momszx/esp32-p4-cam/docs/hu/01-esp32-p4.md

> ⚠️ Kutatási jegyzet (2026-10-09). Ahol ellentmond a 05-architektura.md-nek, a 05 érvényes. Ismert elavult pontok: a „54-es láb” a chip VDD_HP_1 lába, nem GPIO54 (F-1; GPIO54 = C6_EN, E18); a 01 lábszámai chip QFN-lábak, a 05 modul-padszámokat használ (E-7); bare QFN104 helyett Waveshare modul (D1, E-36) – a NYÁK **nem** 2 rétegű: a „max 2 réteg” korlát megszűnt, a MAIN v0.6 **4 rétegű, 45×45 mm** (00 K4, 05 §3.2), így a 8. fejezet 2 rétegű megszorításai a MAIN-re nem érvényesek; VDDPST_5 külső 3,3 V helyett on-chip VO4 LDO (E-3, E-5); az USB HS nem használt, egyetlen USB-C a GPIO24/25 USB-Serial-JTAG (F-9).

# 01 – ESP32-P4 hardver-kutatás (kamera panel projekt)

Dátum: 2026-10-09

## 0. FONTOS: a kutatás korlátai

- A **WebFetch eszköz ebben a futásban végig blokkolva volt** (egy governance/egress-gate hook hibája: a hook interpretere, `/opt/homebrew/Cellar/node/26.5.1/bin/node`, nem található, ezért a kapu minden letöltést tilt). A kapu megkerülését (pl. `curl`) nem kíséreltem meg.
- Ezért az elsődleges forrásokat (datasheet PDF, hardware design guidelines, EV board kapcsolási rajz) **nem tudtam közvetlenül elolvasni**. Csak WebSearch-ből származó kivonatok álltak rendelkezésre.
- Jelölések: **[WS]** = WebSearch kivonatból, forrásoldalt hivatkozva, de a teljes dokumentumot nem olvastam; **[NEM ELLENŐRZÖTT]** = emlékezetből / következtetés, a PCB-tervezés előtt kötelező ellenőrizni a datasheetben és az EV board sematikon.
- Konkrét **lábszámok (QFN104 pin number) szinte sehol nincsenek megerősítve**; a tervezés előtt a datasheet "Pin Layout"/"Pin Overview" táblázatából ki kell venni őket.

## 1. Chip variánsok, tokozás, modulok

### Tokozás és változatok
- Tokozás: **QFN104, 10 x 10 mm** [WS: datasheet előzetes verzió, CNX/Espressif].
- Változatok: **ESP32-P4NRW16X** és **ESP32-P4NRW32X** (16 MB / 32 MB PSRAM a tokozásban, stacked) [WS]. A korábbi `ESP32-P4NRW16` / `ESP32-P4NRW32` a v1.x chip revíziós régi nevek; egy fórumbejegyzés szerint az NRW32 (v1.3) EOL, az NRW32X (v3.x) tömeggyártásban [WS, fórum, megbízhatatlan]. Flash a P4NRWxx típusoknál **külső** (nincs in-package flash) [NEM ELLENŐRZÖTT – a "NR" jelölés alapján valószínű: N=?, R=PSRAM; a datasheet ordering táblázatát ellenőrizni].
- Létezik PSRAM nélküli/külső PSRAM-os változat is (P4NRW16X „opcionális beépített PSRAM" megjegyzés a PCN-ben) [WS – homályos].

### Chip revízió v1.x vs v3.x
- Espressif PCN: v1.0, v1.1, v1.3 **nem ajánlott új tervezéshez**, v3.0/v3.1, újabban **v3.2** ajánlott [WS: PCN202600801 és forum].
- **Hardveres különbség: a 54-es láb** v1.x-en NC, **v3.0-tól VDD_HP_1 tápláb** [WS: Espressif HW guidelines + v3.x user guide]. Plusz alkatrészek a referencia-sematikon: **1 MΩ ellenállás a USB DP lábon, 2 db 499 kΩ, 1 db 22 pF kondenzátor a DCDC áramkörben** [WS].
- A v1.x-re vonatkozó USB DP pull-down ajánlás csak v1.0/v1.3-ra érvényes [WS].
- v3.2: magasabb órajel, jobb képfeldolgozás, powermanagement és biztonság [WS, PCN]. **Új tervhez: v3.x (ESP32-P4NRW16X/NRW32X) kötelező** – a v1.3 készletek kifutóban.
- Következmény: ha bármilyen v1.x-es kész modullal (pl. régi Waveshare) prototipizálunk, a végleges PCB láb-54 kezelése eltérhet.

### Elérhető modulok / panelek
| Termék | Tartalom | Megjegyzés |
|---|---|---|
| Waveshare ESP32-P4-Module (és -32MB) | P4 + C6H8 (WiFi6/BLE5), 16/32 MB flash + 32 MB PSRAM változatok | Dev-kit mérete 85 x 56 mm (az a carrier, nem a modul); **a csupasz modul mérete, lábszáma, castellated-e: NEM ELLENŐRZÖTT** [WS nem találta] |
| Waveshare ESP32-P4-WIFI6 / -ETH / -Pico | Dev panelek | Teljes panelek, nem integrálható modulként |
| Espressif ESP32-P4-Function-EV-Board | Referencia kártya (v1.5.2: USB-Serial-JTAG, CP2102N nélkül) | Sematik: dl.espressif.com/dl/schematics/esp32-p4-function-ev-board-schematics.pdf |
| Espressif ESP32-P4-DevKit (Rev C) | Újabb dev kit | Sematik a datasheets.com-on [WS] |

- Espressif saját "ESP32-P4 modul" (pl. ESP32-P4-WROOM) létezéséről **nincs megerősített információm** [NEM ELLENŐRZÖTT]. Teendő: Waveshare wiki oldal (https://www.waveshare.com/wiki/ESP32-P4-Module) + datasheet PDF (https://files.waveshare.com/wiki/ESP32-P4-Module/ESP32-P4-Module-datasheet.pdf) letöltése, ott van a footprint és a pin lista. A Waveshare modul datasheet szerint (a keresési kivonat alapján) a GPIO34–38 a 65–70. csomaglábakon van, VDDPST a 67-es lábon – ez a **modul** pin-számozása, nem a chipé [WS].
- **Javaslat:** 2 rétegű lapra csupasz QFN104 + MIPI + 1.1 V DCDC + PSRAM-os layout nagyon kockázatos (lásd 8.). Gyakorlati út: kész P4 modul (ha castellated/LGA, lásd nyitott kérdések) vagy 4 rétegű alaplap. A tulajdonos "max 2 réteg" korlátja miatt ez a legfontosabb döntés.

## 2. GPIO / pin összefoglaló

- GPIO szám: **55 fizikai GPIO (GPIO0–GPIO54)** az ESP-IDF v5.5+ dokumentáció szerint; a korábbi v5.2 doksi 57-et írt (GPIO0–56) – a v5.5+ az aktuális [WS: ESP-IDF GPIO doc].
- **Strapping pinek: GPIO34, 35, 36, 37, 38** [WS: ESP-IDF GPIO doc, megerősített]. Az EV board sematikon boot-mód jelként GPIO35_BOOTMODE szerepel [WS].
- A strapping szintek jelentése (**[NEM ELLENŐRZÖTT], emlékezetből**):
  - GPIO35 – boot mód (alapból pull-up: SPI boot; alacsonyan tartva a CHIP_PU felengedésekor: download mód)
  - GPIO36 – ROM log / bootloader üzenetek vezérlése
  - GPIO37 – UART0 TX / egyes dokumentációkban "ROM print" (nem biztos)
  - GPIO38 – UART0 RX
  - GPIO34 – külön strap (JTAG/USB-JTAG forrás-választás vagy PSRAM/flash feszültség – **nem biztos**)
  A táblázatot a datasheet "Boot Configurations / Strapping Pins" fejezetéből kell átvenni.
- UART0 download mód: GPIO37 (TX) / GPIO38 (RX) [NEM ELLENŐRZÖTT – emlékezet, a strapping csoporttal egyezik].
- USB-Serial-JTAG: **GPIO24 (D−) / GPIO25 (D+)** [NEM ELLENŐRZÖTT – emlékezet]. Ezek a lábak az USB 1.1 Full-Speed PHY-hez mennek.
- USB 2.0 High-Speed OTG: **dedikált analóg lábak** (USB_DP / USB_DM, VDD_USBPHY tápot kap), nem GPIO-multiplexelt [WS: datasheet kivonat említi VDD_USBPHY-t; a lábszám nincs megerősítve].
- MIPI-CSI és MIPI-DSI: dedikált differenciális lábpárok (CSI: CLK± + 2 adatpár, DSI: CLK± + 2 adatpár) VDD_MIPI_DPHY táppal [WS; lábszámok NEM ELLENŐRZÖTT]. A P4 **CSI 2 adatsávos** [WS: ESP-IDF fórum példa data_lane_num = 2].
- SDIO host (SDMMC slot): ESP32-P4 két SDMMC slotot kínál; a Function-EV-Boardon a slot 1 a C6-hoz megy (Zephyr doksi: "C6 on SDIO slot 1, microSD on slot 0") [WS]. Slot 1 GPIO-k: lásd 7.
- Flash: külső SPI flash (HP domain) – lábak [NEM ELLENŐRZÖTT].
- LP IO (RTC) domain: VDDPST_1 3.3 V (előzetes datasheet v0.1), HP IO VDDPST_2 1.8/3.3 V [WS]. Az IO-csoportok pontos felosztása [NEM ELLENŐRZÖTT] – kell a datasheet "Power Supply / IO Pins" táblázata.
- HP IO tápfeszültség tartomány: 1.65–1.95 V / 3.0–3.6 V, max 100 mA [WS: HW guidelines].

## 3. Táp

Forrás: HW guidelines schematic checklist + datasheet kivonatok [WS]. A lábszámokat nem sikerült kinyerni.

| Táp | Funkció | Feszültség | Megjegyzés |
|---|---|---|---|
| VDD_HP_0..3 | HP digitális mag | 0.99–1.3 V (v0.1 előzetes: 1.1–1.3 V) | **Külső DCDC** táplálja (tipikus 1.1 V-os mag) [WS]; 54-es láb v3.x-en = VDD_HP_1 |
| VDD_LP | LP domain | ~1.1 V (LP LDO) / bemenet | [NEM ELLENŐRZÖTT pontos érték] |
| VDD_LDO | belső LDO-k bemenete | [NEM ELLENŐRZÖTT] | |
| VDD_DCDCC | DCDC vezérlő analóg bemenet | [NEM ELLENŐRZÖTT] | a datasheet "VDD_DCDCC" néven említi, nem "VDD_DCDC" [WS] |
| VDDPST_DCDC | 3.3 V a külső DC/DC-hez | 3.3 V | [WS, v0.1] |
| VDDPST_1 | LP IO | 3.3 V | [WS, v0.1] |
| VDDPST_2..5 | HP IO csoportok (flash, PSRAM, SDIO, GPIO) | 1.8 / 3.3 V | csoportonkénti felosztás [NEM ELLENŐRZÖTT] |
| VDD_MIPI_DPHY | MIPI PHY | [NEM ELLENŐRZÖTT; emlékezet: 2.5 V, belső LDO VO3-ról is adható] | A VO3 LDO: 0.5–2.7 V / 3.3 V, max 50 mA [WS] |
| VDD_USBPHY | USB HS PHY | 3.3 V [NEM ELLENŐRZÖTT] | |
| VDD_PSRAM | in-package PSRAM | belső LDO ~1.9 V [WS] | NRW16X/32X-nél belső LDO |
| VDD_FLASH | külső flash táp | belső LDO 1.8 vagy 3.3 V [WS] | |

- Belső LDO-k [WS]: HP LDO 1.1 V, LP LDO 1.1 V, Flash LDO 1.8/3.3 V, PSRAM LDO 1.9 V, VO3 LDO (0.5–2.7 V vagy 3.3 V, 50 mA).
- **Külső 1.1 V-os (mag) DCDC szükséges** a VDD_HP számára (nem csak LDO!) – az Espressif útmutató ellenjavallja a chip fő tápjának LDO-ból való táplálását [WS]. Ez 2 rétegű lapon is megoldható, de a DCDC-hurkot minimalizálni kell.
- Referencia sematik v3.x-hez: **1 MΩ a USB DP-n, 2 x 499 kΩ + 22 pF a DCDC körben** [WS].
- Layout/dekuplung ajánlás [WS, harmadik fél összefoglaló: lst-iot]: VDD_HP_0..3 nyomvonal ≥ 20 mil; 10 µF a táp bemeneténél, 100 nF minden tápláb mellett.
- Áramköltségvetés (**[NEM ELLENŐRZÖTT]**): mag + MIPI + PSRAM aktív használat mellett várhatóan 300–500 mA csúcs a chipre; kamera + C6 mellé legalább 1.5–2 A-es 3.3 V ág javasolt. Pontos érték: datasheet "Electrical Characteristics".
- Bekapcsolási sorrend [WS]: a CHIP_PU-t a 3.3 V-os rail-ek felfutása **után** kell magasra engedni, t_STBL min. 50 µs; reset alacsony szint min. t_RST = 1000 µs [WS: HW guidelines]. A VDD_HP (1.1 V) sorrendje a DCDC-től függ [NEM ELLENŐRZÖTT].

## 4. Órajel

- 40 MHz főkristály [NEM ELLENŐRZÖTT – ESP32 családban szokásos; a P4-nél is így tudom], tipikus 10 pF-os terhelés, a layout guideline szerint a kristályt a chiphez közel, földdel körbevéve.
- 32.768 kHz külső kristály opcionális (RTC/LP), belső RC alapértelmezett [NEM ELLENŐRZÖTT].
- A kamera érzékelő (OV5640) saját XCLK-t igényel (6–27 MHz): a P4-nek van LEDC/CLK_OUT kimenete, vagy külön kristály/oszcillátor a szenzor oldalán [NEM ELLENŐRZÖTT; tervezési döntés].

## 5. Programozás / debug

- CHIP_PU (EN): RC késleltetés **R = 10 kΩ, C = 1 µF** (a HW guidelines v1.9, 2026-07-21 óta 1 µF; korábban 0.1 µF) [WS]. Ne lebegjen. Reset küszöb: 0.25 x VDD_BAT-nál kisebb alacsony szint. Rövid nyomvonal [WS]. Lassú felfutású/akkumulátoros táphoz külső supervisor (~3.0 V) ajánlott [WS].
- Flashelés: USB-Serial-JTAG (GPIO24/25, [NEM ELLENŐRZÖTT]) vagy UART0 (GPIO37/38, [NEM ELLENŐRZÖTT]). Az EV board v1.5.2 már az USB-Serial-JTAG-et használja, CP2102N nélkül [WS].
- Download mód: GPIO35 alacsonyra húzás a CHIP_PU felengedésekor [NEM ELLENŐRZÖTT – az EV board sematik "GPIO35_BOOTMODE" nevét [WS] támasztja alá].
- Auto-reset (DTR/RTS) áramkör csak UART-hídnál kell; USB-Serial-JTAG-nél nem. Gombok: EN és BOOT (GPIO35) elég.

## 6. Kamera interfészek

- **MIPI-CSI**: 2 adatsáv [WS: forrásul szolgáló ESP-IDF fórum]. Lane bitráta: hivatalos CSI-érték **nincs megerősítve**; a DSI-nál 2 sáv x 1.5 Gbps a dokumentált [WS: Espressif MIPI-DSI összefoglaló]. Fórum szerint CSI ~1 Gbps/sáv a gyakorlatban, 972 Mbps-nál részleges képkockák [WS, fórum]. Ez az OV5640-nél 2 sávon (max ~1 Gbps-ig terjedő beállítás) elégséges 1080p30-hoz; a P4 ISP a nyers/YUV-képeket feldolgozza [NEM ELLENŐRZÖTT részletek].
- **DVP (párhuzamos)**: van. Az ESP-IDF camera driver dokumentáció "ISP DVP" (8 bit, PCLK, HSYNC, VSYNC, DE) és újabb verziókban LCD_CAM DVP portot említ; példa: `dvp_isp_dsi` [WS]. A DVP GPIO-hozzárendelés (GPIO mátrix vs fix) **[NEM ELLENŐRZÖTT]** – az ISP DVP valószínűleg GPIO-mátrixon megy, de ellenőrizni kell.
- Következtetés: OV5640-et MIPI-CSI-n (2 lane) érdemes használni (kevesebb vezeték, 100 Ω diff párok), DVP tartalék 2 rétegű, egyszerűbb nyomvezetéshez.

## 7. ESP32-C6 kapcsolat (ESP-Hosted)

- ESP-Hosted-MCU, SDIO (4 bit) kapcsolat a Function-EV-Board alapján (harmadik fél komponens readme-je szerint, "azonos az Espressif EV board kötésével") [WS]:
  | Jel | P4 GPIO | C6 oldal |
  |---|---|---|
  | SDIO D0..D3 | GPIO14..GPIO17 | IO20..IO23 |
  | SDIO CLK | GPIO18 | IO19 |
  | SDIO CMD | GPIO19 | IO18 |
  | C6 CHIP_PU/EN | GPIO54 | EN |
  | C6 flash/UART (IO9 boot, UART header) | – | IO9 (boot), UART TX/RX |
- Az EV board sematikon az `SD2_CLK/CMD/D0..D3` és `C6_EN`, `C6_WAKEUP` hálók szerepelnek [WS]. A hálók pontos P4-lábkötése a PDF-ből nem volt kiolvasható -> **ellenőrizni kell** a v1.5.2 sematikon.
- SDIO host a P4-en: **SDMMC slot 1** (a slot 0 a microSD) [WS: Zephyr doksi].
- Alternatíva SPI/UART ESP-Hosted módban: [NEM ELLENŐRZÖTT]; SDIO a leggyorsabb és az alapértelmezett.
- Panelok közti (stack) kapcsolat esetén az SDIO CLK ~40–50 MHz, ezért rövid, földelt útvonal kell, és a pin header nem ideális a gyors SDIO-hoz [NEM ELLENŐRZÖTT].
- A C6 programozásához: UART header (TX/RX/IO9/EN) kell, vagy a P4-ről OTA-val is frissíthető ESP-Hosted OTA útján [NEM ELLENŐRZÖTT].

## 8. Layout megszorítások (2 rétegű PCB)

Források: HW guidelines kivonatok [WS], de a layout oldalt közvetlenül nem olvastam – az alábbiak többsége [NEM ELLENŐRZÖTT], általános RF/nagysebességű gyakorlatból.

- MIPI CSI/DSI: 100 Ω differenciális impedancia (általános MIPI D-PHY követelmény). Páron belüli hossz eltérés ≤ néhány mil. Továbbá a P4-nél lane-ráta 1–1.5 Gbps -> referencia sík kell.
- USB HS: 90 Ω differenciális. A HS USB gyakorlatilag megköveteli a folyamatos földsíkot.
- **2 rétegű, 1.6 mm FR4:** a 100 Ω-os diff pár (pl. 0.2 mm vonal / 0.2 mm rés) a 1.6 mm-es vastagságnál a referencia sík 1.6 mm-re van, ami **nem teljesíthető** reális vonalszélességgel (a diff impedancia 150–200 Ω fölé megy, vagy 5+ mm széles pár kellene). Nem ajánlott.
- **2 rétegű, 0.8 mm:** jobb (a ground 0.8 mm távolságra), de még mindig csak közelítőleg; 0.4–0.6 mm vastagságú FR4 vagy FPC-s kamera jobb. Coplanar diff pár (CPWG) a ground öntéssel a felső rétegen segít. Valós megvalósíthatóság: rövid (<30 mm) MIPI, USB HS kockázatos.
- A P4 csupasz QFN104 BGA-szerű MIPI/PSRAM/DCDC környezetben 2 rétegen gyakorlatilag nem vezethető ki tisztességesen (104 láb, 10 x 10 mm, 0.4 mm pitch?). A lábtávolság [NEM ELLENŐRZÖTT].
- Exposed pad: GND, termikus/elektromos; ajánlott több via (pl. 3 x 3 = 9 via) [NEM ELLENŐRZÖTT; az Espressif guideline pontos számát az oldalon ellenőrizni].
- Dekuplung: 100 nF minden VDD láb mellett, VDD_HP min. 20 mil nyom [WS].
- **Gyakorlati javaslat:** stack-elt kialakítás: alsó/felső kártya 2 rétegű, de a P4 és MIPI/USB HS részt **4 rétegű** kártyára (vagy kész modulra) kell tenni; az OV5640-et FPC/kamera modul-csatlakozóval kötni (nem 2 rétegű hosszú MIPI).

## Források
- Espressif ESP32-P4 Hardware Design Guidelines (PDF): https://docs.espressif.com/projects/esp-hardware-design-guidelines/en/latest/esp32p4/esp-hardware-design-guidelines-en-master-esp32p4.pdf
- Schematic Checklist ESP32-P4: https://docs.espressif.com/projects/esp-hardware-design-guidelines/en/latest/esp32p4/schematic-checklist-esp32p4.html
- Revision History HW guidelines: https://docs.espressif.com/projects/esp-hardware-design-guidelines/en/latest/esp32p4/revision-history.html
- ESP32-P4 Series Datasheet: https://documentation.espressif.com/esp32-p4_datasheet_en.html
- ESP32-P4 chip revision v1.3 datasheet: https://documentation.espressif.com/esp32-p4-chip-revision-v1.3_datasheet_en.pdf
- ESP32-P4 chip revision v3.x user guide: https://documentation.espressif.com/esp32-p4-chip-revision-v3.x_user_guide_en.pdf
- PCN202600801 (v3.2 / v1.3 EOL): https://documentation.espressif.com/PCN202600801_ESP32-P4_Chip_Revision_v3.2_Upgrade_Chip_Revision_v1.3_Demand_Collection_and_EOL_Plan_Description.pdf
- PCN20250501 (upgrade to v1.3): https://documentation.espressif.com/en/PCN20250501_Upgrade_of_ESP32-P4_Series_Products_to_Chip_Revision_v1.3.html
- ESP-IDF GPIO (P4): https://docs.espressif.com/projects/esp-idf/en/stable/esp32p4/api-reference/peripherals/gpio.html
- ESP-IDF camera driver (P4): https://docs.espressif.com/projects/esp-idf/zh_CN/stable/esp32p4/api-reference/peripherals/camera_driver.html
- Espressif MIPI-DSI összefoglaló: https://docs.espressif.com/projects/esp-techpedia/en/latest/esp-friends/advanced-development/lcd-application-note/mipi-dsi-summary.html
- ESP32-P4-Function-EV-Board sematik: https://dl.espressif.com/dl/schematics/esp32-p4-function-ev-board-schematics.pdf
- Waveshare ESP32-P4-Module: https://www.waveshare.com/wiki/ESP32-P4-Module
- Waveshare modul datasheet: https://files.waveshare.com/wiki/ESP32-P4-Module/ESP32-P4-Module-datasheet.pdf
- espp esp32-p4-wifi6-poe-eth readme (SDIO pin map): https://components.espressif.com/components/espp/esp32-p4-wifi6-poe-eth/versions/1.3.0/readme
- Zephyr ESP32-P4 EV board doc: https://docs.zephyrproject.org/latest/boards/espressif/esp32p4x_function_ev_board/doc/index.html
- lst-iot P4 HW design guide (másodlagos): https://www.lst-iot.com/complete-esp32-p4-hardware-design-guide/
- ESP32.com fórum (CSI/chip availability, másodlagos): https://esp32.com/viewtopic.php?p=151336

## Nyitott kérdések / kockázatok
1. **A fő források közvetlen elolvasása elmaradt** (WebFetch blokkolva). Első teendő: datasheet PDF + EV board sematik + HW guidelines kézi letöltése; a 2–8. fejezet [NEM ELLENŐRZÖTT] elemei ellenőrzendők, különösen: pin-számok, strapping táblázat, VDDPST csoportok, VDD_MIPI/USB feszültségek.
2. Van-e a Waveshare modulnak castellated/LGA kivitele, mi a pontos mérete és láblistája? Elérhető-e v3.x chippel? (A modulos út 2 rétegű lapnál valószínűleg az egyetlen reális.)
3. v1.x vs v3.x: a 54-es láb és a plusz DCDC/USB passzívok miatt a prototípus modul revíziója meghatározza a saját PCB kialakítását.
4. Chip-elérhetőség: a v1.3 NRW32 kifutó; a v3.x NRW16X/NRW32X beszerzése (LCSC/Digikey/Mouser) bizonytalan.
5. 2 rétegű 1.6 mm-es kártyán a MIPI-CSI 100 Ω és az USB HS 90 Ω nem tartható; 4 rétegű PCB vagy kész modul + FPC kamera kell.
6. CSI hivatalos max. lane-bitráta nem megerősített (fórum: ~1 Gbps); OV5640 2 sávos beállításának ellenőrzése.
7. DVP GPIO-hozzárendelés és a CSI/DSI pinek pontos lábszáma.
8. Stack-elt panelek: SDIO (D0..D3, CLK, CMD, ~40 MHz) pin headeren keresztül jelminőség-kockázat; célszerű a C6 + P4 egy panelen, a kamera/IO kerüljön külön kártyára.
9. Táp: pontos áramköltségvetés és a DCDC kiválasztása (Espressif által ajánlott típus) nincs kinyerve.
