momszx/esp32-p4-cam/docs/hu/06-floorplan-vazlat.md

# 06 – Floorplan vázlat: terület- és magasságköltségvetés (v0.3; as-built kiegészítés 2026-10-10, végső rev A as-built 2026-10-11)

Dátum: 2026-10-09 · Státusz: **tervezői vázlat, review-célra** · Alap: `05-architektura.md` **v0.5** (Rev A terv: §0), `07-bom-terv.md`, `90-review-log.md`
Jelölés: **[F]** = feltételezés (nem mért, nem primer forrásból) – a Q5 (kamera modul) és a Waveshare footprint/STEP után felülvizsgálandó. Minden méret mm. Hivatkozás-előtag: **06-Kn** = e dokumentum Kn konfliktusa, **00-Kn** = követelmény.
Változás v0.1 → v0.2: **G = 7,0 mm** (a Z-összegek újraszámolva, kamera alatti limit **3,3 mm**); ESD = 3,3 V array; CC-tap = 100k + 10 nF + Zener (DNP rev A); TP8 a MAIN front oldalán; a költségvetés kiegészítve (IR eFuse #2 + shunt, CAM_3V3 switch, supervisor, USER gomb, NTC, VBUS osztó, DNP header, bypass-ok); eFuse bulk 35–50 V; PDM soros R a FRONT-ra került; modul 3V3 bulk egy érték; TP1–TP17; FFC 25–30 mm; lencse-kivágás indoklás javítva; modul-lábnyom 28×28 (K-10); új K14 (CSI pad-sorrend), K15 (lapméret).
> ⚠️ **Felülírva (as-built, 2026-10-10):** a §0–§6 a **60×50 mm / 2 rétegű** rev A tervre és egy szimmetrikus 45×45-ös „magra” épül – ez **elavult**. A MAIN v0.6 **45×45 mm, 4 réteg**; az M2 raszter középpontja **(22,5; 25,0)**, nem a lapközép (a §1 „sarkoktól 5,75 mm” csak X-ben igaz: Y-ban 8,25 / 3,25 mm). Érvényes: a v0.6 szakaszok a dokumentum végén, az **„As-built elhelyezés”** tábla és a befagyasztott interfész a `05` §3.1a-ban. A Z-stack (§3) és a FRONT-költségvetés (§2.3–§2.4) számai továbbra is irányadók.

Változás v0.2 → v0.3 (R4): **TP-terv a 05 §12 szerint** (hátoldali pogo csoport TP1–TP7, TP9–TP17 = 18 pad + 2 GND; TP4–TP6 pad-jai is hátul, a 0 Ω jumperek elöl; TP8 front, DNP); **minden 100k lehúzás a MAIN hátoldalon** (a FRONT-ról törölve); **státusz LED a MAIN hátoldalon** (a FRONT-ról törölve); J2 vezérlő-jel ESD a front költségvetésben; USB shield RC és UART0/GPIO 5 passzívok a hátoldalon; K5 számtan pontosítva; a CSI-döntés G3-ban (K14, K12).

## 0. Verdikt röviden

| Kérdés | Verdikt |
|---|---|
| Terület, MAIN hátoldal (modul oldal) | **befér** (kihasználtság ~50 %) |
| Terület, MAIN elülső oldal (kamera felőli) | **befér** (összesen ~56 %, gyűrűre vetítve ~82 %); G = 7-nél a kamera árnyékában ≤3,3 mm alkatrész állhat → a W gyűrű túlterheltsége (06-K5) megoldható |
| Terület, FRONT mindkét oldal | **bőven befér** (elöl ~8 %, hátul ~32 %); a korlát nem a terület, hanem az IR-LED/lencse/mikrofon távolság |
| Z-stack | **G = 7,0 mm**: kamera alatt ≤3,3 mm (G − 3,2 − 0,5); 6,0 mm elvetve |
| Kamera FFC a résben | bring-up: **50–100 mm szabványos FFC, nyitott stack, MAIN önállóan**; zárt stack: **25–30 mm egyedi kábel** (06-K1) |
| CSI útvonal modul (hátoldal) → J2 (front) | szimmetrikus via-pár (05 §13); **a pad-sorrend eltér a J2-től** (E20) → pár-keresztezés várható, ⏳ G3 (06-K14) |

Fő ok: a terület nem szűk keresztmetszet. A szűk keresztmetszet a **peremgyűrű** (a 25×25-ös modul körül 10 mm, a forrasztó pad-hosszabbítás után ~8,5), a **Z-magasság** és az **FFC hossz**.

## 1. Feltételezések

**Padszámozás:** a **jel ↔ pad hozzárendelés primer forrásból való (05 E20)**; a **térbeli elrendezés [F]**: a modul felülnézetből (hátoldalról, a modul oldaláról nézve), pad 1 bal felső sarok, számozás **óramutatóval ellentétes**, 22 pad/oldal, 1,0 mm osztás, az oldal közepére centrálva (a sarkoknál ~2 mm üres). Tehát: bal oldal 1–22 (fentről le), alsó oldal 23–44 (balról jobbra), jobb oldal 45–66 (lentről fel), felső oldal 67–88 (jobbról balra). Következmények (modul-felülnézet koordinátákban, modul 25×25, kezdőpont a modul bal alsó sarka):

| Jel | Pad (E20) | Oldal / hely [F] |
|---|---|---|
| RF (LNA_OUT) | P2 | bal oldal, fent (v≈32,5) |
| C6 UART/IO9/IO8 | P4, P5, P9, P10 | bal oldal, felső harmad |
| CSI | P41 D0N, P42 D0P, P43 CLKP, P44 CLKN / P45 D1N, P46 D1P | alsó oldal jobb vége / jobb oldal alja → **jobb alsó sarok** |
| USB-Serial-JTAG D−/D+ | P50, P51 (a P48/P49 HS PHY NC) | jobb oldal, alulról 6–7. pad (v≈17,5–18,5) |
| BOOT/strapping/UART0 | P62 / P63, P64, P65 | jobb oldal felső fele |
| VO4 | P66 | jobb felső sarok |
| SD | P67–P72 | felső oldal jobb vége |
| VBAT / ESP_3V3 / EN | P84 / P85–P86 / P87 | felső oldal bal fele |

Ha a tényleges footprint más (pl. CW, vagy a sarok-padok be vannak számolva), az egész kiosztást forgatni kell; a terület- és magasságszámok nem változnak.

**Koordinátarendszer:** *termék-keret*: elölről (lencse felől) nézve X jobbra, Y fel; a lap 0..45 × 0..45. A MAIN hátoldalát (modul) **hátulról nézve** rajzolom (modul-felülnézet), ott a jobb-bal a termék-kerethez képest tükrözött: nézeti u = 45 − x. A modul a lap közepén (10..35 × 10..35), **a forrasztó pad-hosszabbítás (K-10: kifelé ≥1,5 mm) miatt a lábnyom 28×28**; a modul 1 mm-rel az USB-C-vel ellentétes él felé tolva. Forgatás 0° a fenti számozással → **termék-keretben** a CSI/J2 a bal alsó sarokban (SW), az USB-C a bal élen (W), az RF/u.FL a jobb felső sarokban (NE), az SD a felső él bal felén, a 3V3 pad-ok a felső él jobb felén.

**Kamera modul [F]:** OV5640 MIPI, 25×24 mm NYÁK, 1,2 mm vastag; hátoldalán FPC aljzat + oszcillátor/LDO, együtt max. 2,0 mm magas; elöl 14×14 négyzetes holder + M12 hordó, optika-magasság a NYÁK elülső síkja felett ~18 mm (M12) vagy ~7 mm (Ø8 hordós AF-változat). **Rev A: NoIR vagy fix lencse**, ICR rev B. **Rögzítés "A" variáns**: a modul NYÁK-ja a FRONT hátsó síkjához fekszik, a holder + hordó egy **16×16 mm** (R1 sarkú) kivágáson át előre nyúlik. ("B" variáns: a holder a FRONT mögött marad, csak a hordó megy át a lyukon → a rés ≥10 mm kellene; nem javasolt.) A 05 szerinti "lencse furat +0,5 mm" ezért egy négyzetes kivágás, nem Ø furat.

**Egyéb [F]:** B2B 2×10, 1,27 mm, SMT: ~15×6 mm, párosított magasság **G = 7,0 mm** (a 7 mm-es 1,27 mm-es B2B elérhetősége [NEM ELLENŐRZÖTT], 05 Q17); lap 1,0 mm; M2 furatok a 33,5 mm raszteren (±16,75 a középtől → a sarkoktól 5,75 mm), keep-out Ø3,8; peremtiltás 0,5 mm; a "+30 %" a földterület/routing/keep-out felár.

## 2. Terület- és magasságköltségvetés

> **Rev A:** a MAIN 60×50 mm (05 0, Q22). Az alábbi számok a **45×45-ös végcélra** vonatkoznak; rev A-ban +975 mm² lapterület a többlet-sávban.

Rendelkezésre álló terület lapról: 45×45 = 2025; −peremtiltás (44×44) = 1936; −4 lyuk keep-out (4×11,3) = 45.

### 2.1 MAIN – hátoldal (modul oldal)

Levonás: modul + kézi forrasztási pad-hosszabbítás = **28×28 = 784**. **Elérhető: 1936 − 784 − 45 = 1107 mm².**

| Alkatrész | W×H | Terület | Magasság | Megjegyzés |
|---|---|---|---|---|
| USB-C 16 pin (top/mid-mount, THT shell) | 9,4×7,5 | 70,5 | 3,2 | a modul 1 mm-es eltolásával ≥2 mm szabad távolság a pad-hosszabbítástól (06-K8) |
| TVS (SMA/SMAJ10A osztály) | 6,8×3,0 | 20,4 | 2,4 | USB-C mellett |
| USB ESD **3,3 V array** (TPD2E2U06 / PRTR5V0U2X osztály, nincs VBUS láb) | 2,9×2,4 | 7 | 1,1 | az USBLC6-2SC6 törölve (05 B-1) |
| u.FL + π-háló (3×0603) – minden elem 0 Ω / DNP-képes | 3,4×3,0 + 6×2 | 22 | 1,25 | rev A: a modul saját IPEX-e alternatíva (05 G2) |
| BOOT + RESET + **USER** (3× SMD tact) | 3× 4,5×3,8 | 51,3 | 2,0 | lapszélen |
| **Supervisor** (nyílt-drain) + 0 Ω → ESP_EN + 100 nF (**DNP rev A**) | – | 12 | 1,0 | az EN (P87) közelében |
| Modul 3V3 bulk (**47 µF 1210 + 10 µF 0805 + 100 nF**) | – | 22 | 2,5 | a P84–P86 pad-oknál; egy érték, 05-tel azonos |
| VO4 1 µF + TP, strapping/felhúzás (6×0603) | – | 33 | 0,5 | C6_IO8/IO9 10k felhúzás, GPIO36 10k |
| Pogo TP csoport **TP1–TP7, TP9–TP17** (TP9a/b, TP16a/b kettéosztva) = **18 pad** (17 jel + TP3 GND) **+ 2 GND pad = 20 pad**, 2,0 mm raszter, Ø1,5 pad | ~22×5 | 95 | 0 | a C6 TP-k (TP10–13) külön, bal gyűrű; a TP4–TP6 pad-jai is itt (a 0 Ω jumperek elöl, via-val kivezetve, 05 §12); TP8 a front oldalon |
| **C6 + UART0 DNP header footprint** (1,27 / 2,54 mm) | ~12×3 | 36 | 0 (DNP) | a P2 (RF) padtól távoli élen (05 K-17) |
| Státusz LED 0603 + soros R (GPIO 6) | – | 9 | 0,6 | a modul közelében (a FRONT-ról ide került, 05 §5) |
| USB shield RC (1 MΩ ‖ 4,7 nF, 2×0603) | – | 6 | 0,5 | a J1 THT shield lábai mellett |
| Kisalkatrészek: **100k lehúzások (GPIO 26–28, 32 hátoldal; GPIO 53, 4 előlap a cél-IC mellett – v0.6)**, UART0 soros R ×2, GPIO 33 (USER) 100 nF, I2C felhúzás (DNP) | – | 45 | 0,5 | a lehúzások a modul közelében (05 K-7); a PDM soros R a FRONT-on van (nem itt); a VBUS osztó a front oldalon |
| **Összeg** | | **429,2** | | |
| **+30 %** | | **558** | | |
| **Kihasználtság** | | **558 / 1107 = 50 %** | | |

Legmagasabb: modul 3,3 mm; USB-C 3,2 mm.
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
