momszx/esp32-p4-cam/docs/hu/08-diagramok.md

# 08 – Diagramok (Mermaid, v0.4)

Dátum: 2026-10-09 · **v0.4 (2026-10-11): végső rev A as-built – D1 TVS az U3 alatt, U5 / R1 / C1 a front oldalon, új C14, G4 lezárva, G5 rendelés előtti kapu, G5b CSI soak** – lásd „Diagram-javítások (v0.4)” a végén · **v0.3 (2026-10-10): GPIO-kiosztás v0.6 (SD_EN 53, SD_CD 52, CAM_3V3_EN 4, USER 33, EFUSE_FLT 29, PDM_DATA 30), MAIN 45×45 / 4 réteg, as-built TP-k (TP9–TP15 törölve, C6/UART0 a J7 padsoron), 2026-10-10-i döntések (R23/C25 FIT, D2 DNP, R28 10k, kamera vezérlő-ESD → rev B)** – lásd „Diagram-javítások (v0.3)” a végén · Forrás: `05-architektura.md` v0.5 (autoritatív), `06-floorplan-vazlat.md` v0.3, `07-bom-terv.md` v0.2 · **v0.2 (R4): a hibalista javítva, a diagramok a 05/06/07 javított állapotát mutatják** (lásd "Diagram-javítások" a végén) · A diagramok **kizárólag** a 05 táblázataiból / szövegéből épülnek; a 06 és 07 csak a lap-oldal (front / rear) és a pin-térkép kiegészítésére szolgál, ahol a 05 hallgat (ezt az élcímke jelzi).

## Jelmagyarázat (minden diagramra)

| Jelölés | Jelentés |
|---|---|
| Folytonos nyíl, `§n` az élcímkén | a kapcsolat a 05 megadott szakaszában szerepel (`E20` = 05 §1 pad-térkép, `07 §3` = USB-C pin map) |
| Szaggatott nyíl | DNP-ág vagy opcionális kapcsolat (a v0.1 "HIÁNYZIK 05-ből" élei a javítások után mind rögzítve vannak, lásd a hibalistát) |
| Szaggatott **piros** keretű csomópont | rev A **DNP** (05 §0.1; footprint van, nincs beültetve) |
| Szaggatott **kék** keretű csomópont | **később (G6)**, a FRONT lapon (05 §0.1, §0.2) |
| Egyszerű keret | rev A **FIT** |

A modul pad = `P`-szám, processzor láb = `GPIO n` (05 jelölés-szabály). A pin-sorszámozás térbeli elrendezése **[F]** (feltételezés) a footprint-importig (05 §14, 06 §1) – **v0.3: a footprint importálva, a DXF-fel egyezik; a GPIO ↔ pad ↔ háló hozzárendelés a NYÁK U1 padjairól ellenőrizve (05 §5).**

---
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
