momszx/esp32-p4-cam/docs/img/main_revA_autoroute.png

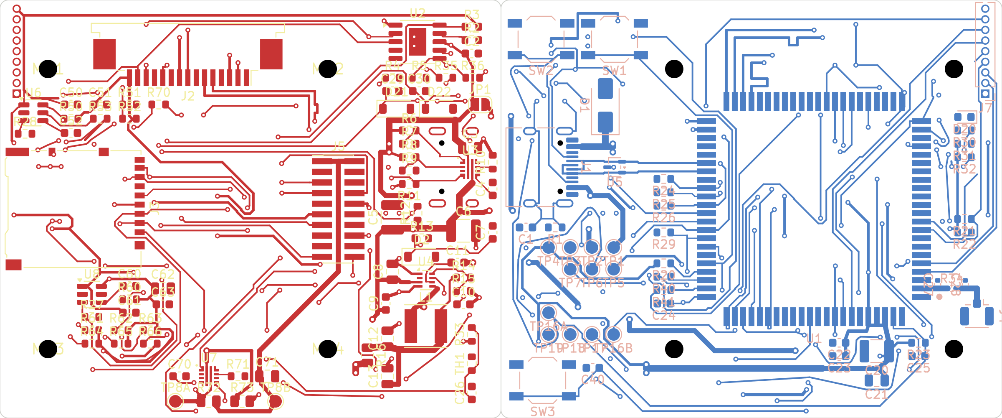
docs/img/main_revA_autoroute.png
