momszx/esp32-p4-cam/docs/img/main_revA_back_placement.png

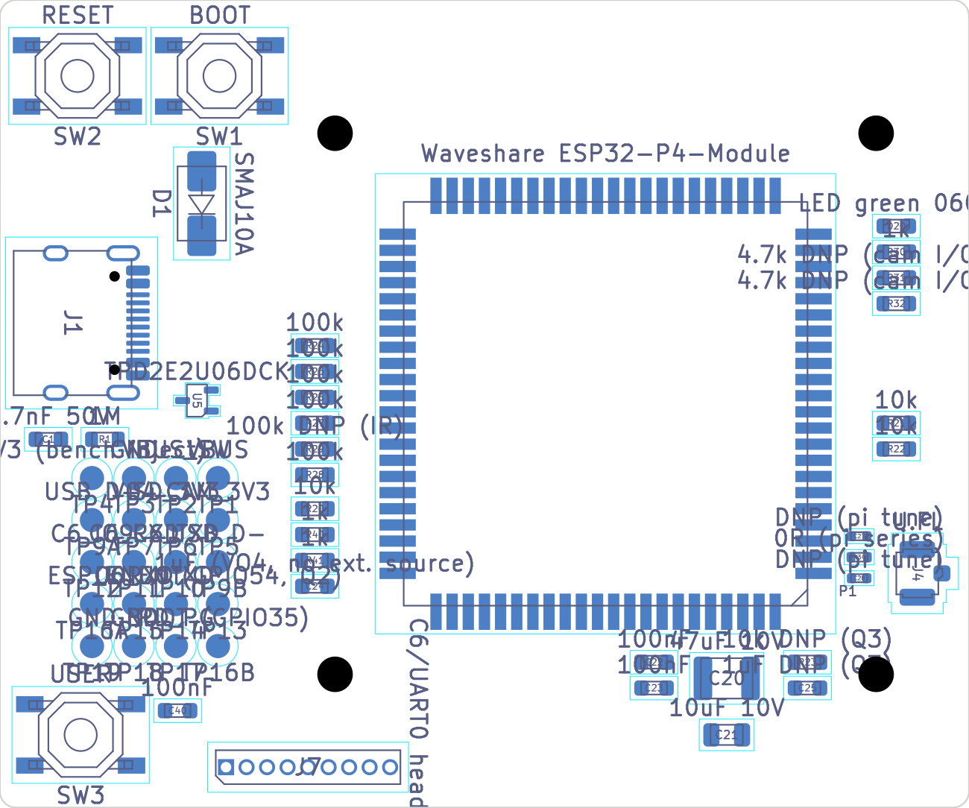
docs/img/main_revA_back_placement.png
