momszx/esp32-p4-cam/docs/img/main_revA_front_placement.png

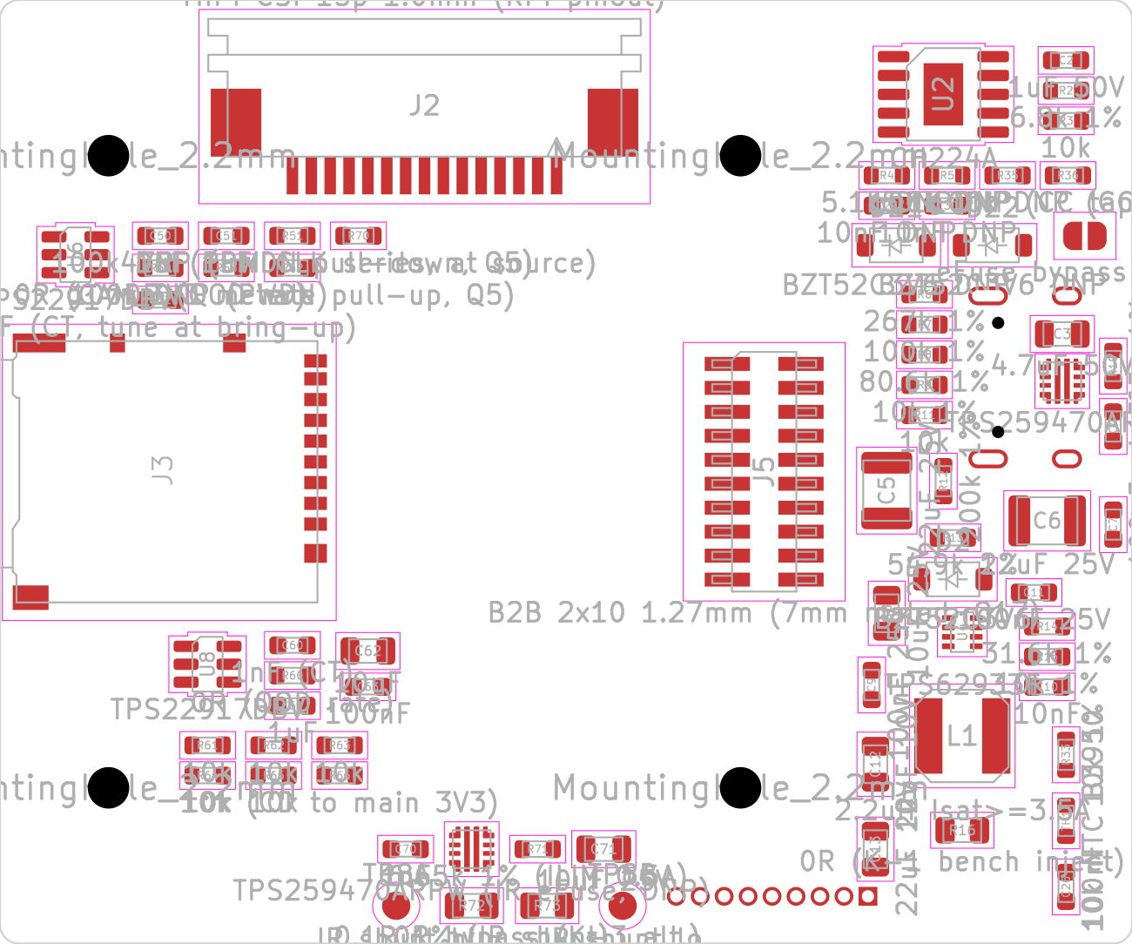
docs/img/main_revA_front_placement.png
