momszx/esp32-p4-cam/docs/img/main_revA_pour.png

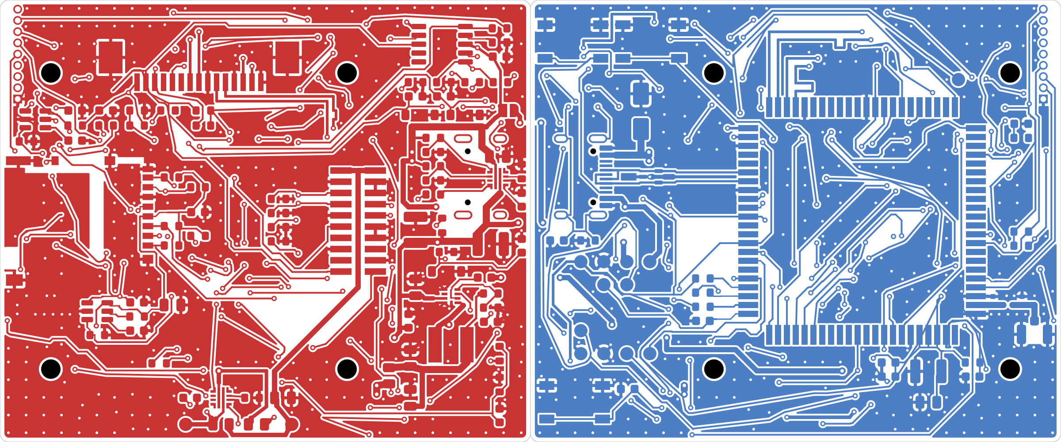
docs/img/main_revA_pour.png
