momszx/esp32-p4-cam/docs/img/main_revA_power_routing.png

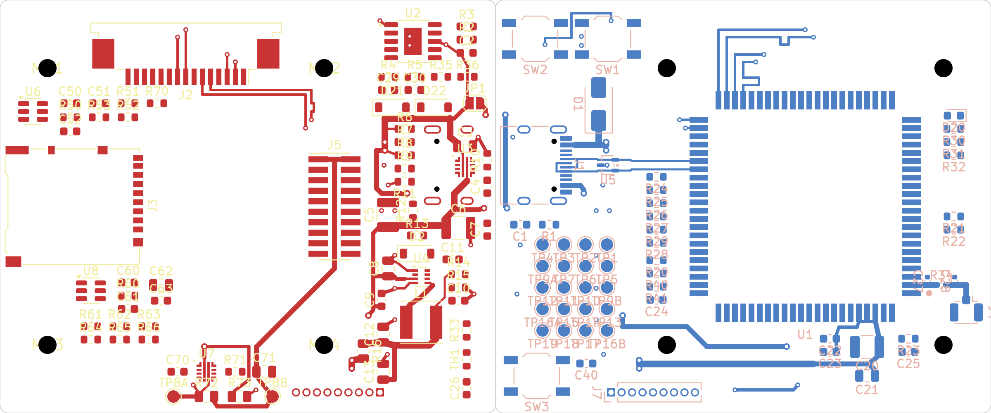
docs/img/main_revA_power_routing.png
