momszx/esp32-p4-cam/docs/img/main_revA_routed.png

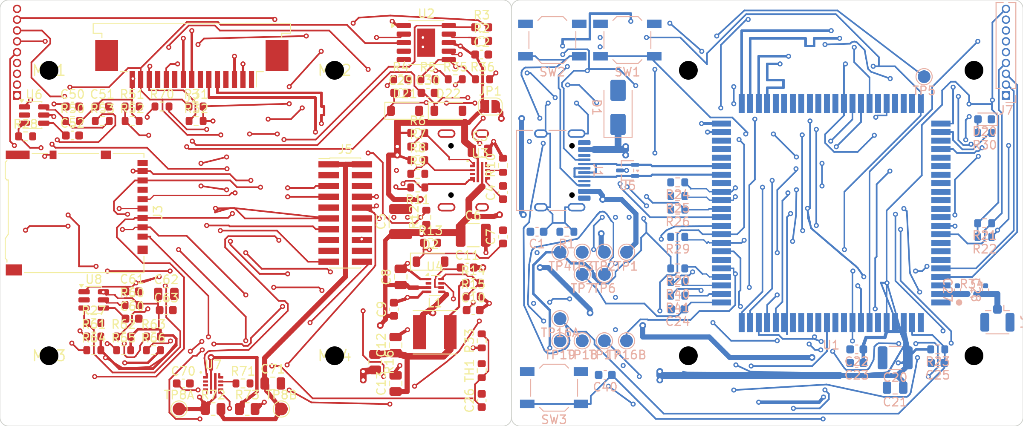
docs/img/main_revA_routed.png
