momszx/esp32-p4-cam/docs/img/main_v06_45x45_placement.png

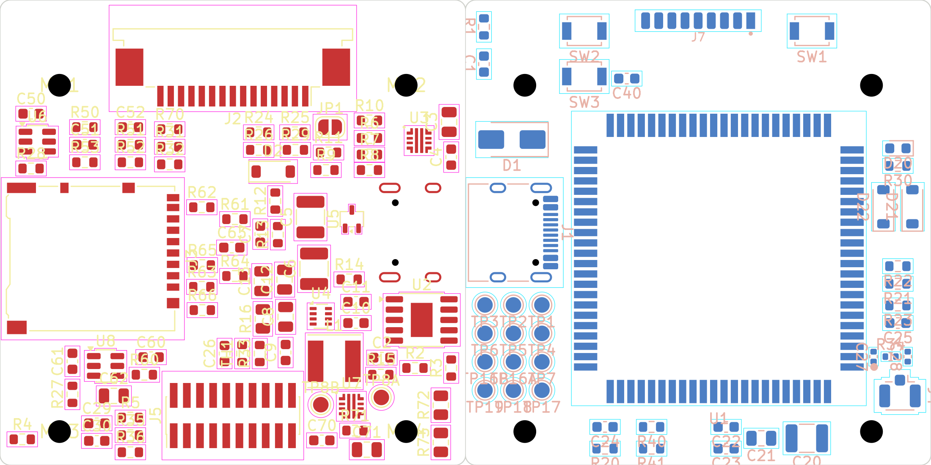
docs/img/main_v06_45x45_placement.png
