momszx/esp32-p4-cam/docs/img/main_v06_routing.png

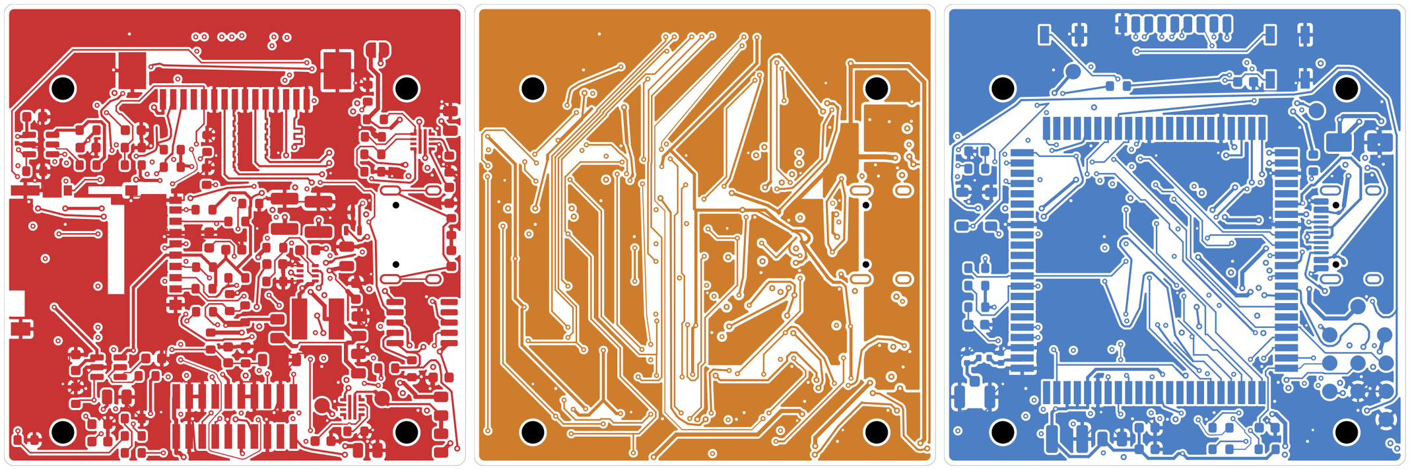
docs/img/main_v06_routing.png
