momszx/esp32-p4-cam/kicad/MAIN/fab/BOM_jlc.csv

Comment | Designator | Footprint | LCSC
4.7nF 200V X7R ±10% 0603 | C1 | C_0603_1608Metric | C596328
1uF 50V X5R ±10% 0603 | C2,C24,C25,C50,C51 | C_0603_1608Metric | C15849
4.7uF 50V X5R ±10% 0805 | C3 | C_0805_2012Metric | C98192
1nF 50V X7R ±10% 0603 | C4,C52 | C_0603_1608Metric | C1588
22uF 25V X5R ±10% 1210 | C5,C6 | C_1210_3225Metric | C52306
100nF 50V X7R ±10% 0603 | C7,C9,C11,C22,C23,C26,C40 | C_0603_1608Metric | C14663
10uF 25V X5R ±10% 0805 | C8,C21 | C_0805_2012Metric | C15850
10nF 50V X7R ±10% 0603 | C10 | C_0603_1608Metric | C57112
22uF 25V X5R ±20% 0805 | C12,C13 | C_0805_2012Metric | C45783
1uF 25V X7R ±10% 0603 | C14 | C_0603_1608Metric | C29936
47uF 16V X5R ±10% 1210 | C20 | C_1210_3225Metric | C77101
TVS uni 10V SMA 400W | D1 | D_SMA | C134939
LED emerald green 525nm 0603 | D20 | LED_0603_1608Metric | C12624
USB-C 16P receptacle SMD + 4 shell legs | J1 | USB_C_Receptacle_HRO_TYPE-C-31-M-12 | C165948
FPC 15P 1.0mm slide-lock, TOP contact, SMT right angle | J2 | TE_1-84953-5_1x15-1MP_P1.0mm_Horizontal | C5164008
U.FL receptacle SMD | J4 | U.FL_Hirose_U.FL-R-SMT-1_Vertical | C88374
Pin header 2x10 1.27mm SMD vertical, insulator 1.0mm, mating pin 4.0mm | J5 | PinHeader_2x10_P1.27mm_Vertical_SMD | C41375929
2.2uH ±30% Isat 4.1A Irms 3.1A 29mΩ 4.9x4.9x2.4mm | L1 | L_Taiyo-Yuden_NR-50xx | C222926
1MΩ ±1% 0603 | R1 | R_0603_1608Metric | C22935
6.8kΩ ±1% 0603 | R2 | R_0603_1608Metric | C23212
10kΩ ±1% 0603 | R3,R9,R11,R15,R20,R21,R22,R23,R28,R33 | R_0603_1608Metric | C25804
267kΩ ±1% 0603 | R6 | R_0603_1608Metric | C22963
100kΩ ±1% 0603 | R7,R24,R25,R26,R27 | R_0603_1608Metric | C25803
80.6kΩ ±1% 0603 | R8 | R_0603_1608Metric | C23249
1.65kΩ ±1% 0603 | R10 | R_0603_1608Metric | C22845
200kΩ ±1% 0603 | R12 | R_0603_1608Metric | C25811
54.9kΩ ±1% 0603 | R13 | R_0603_1608Metric | C23077
31.6kΩ ±1% 0603 | R14 | R_0603_1608Metric | C25967
0Ω 0805 | R16 | R_0805_2012Metric | C17477
1kΩ ±1% 0603 | R30,R40,R41 | R_0603_1608Metric | C21190
0Ω 0402 | R34 | R_0402_1005Metric | C17168
0Ω 0603 | R50,R53 | R_0603_1608Metric | C21189
47Ω ±1% 0603 | R70 | R_0603_1608Metric | C23182
Tactile switch SPST 3.0x2.5mm SMD | SW1,SW2,SW3 | SW_SPST_B3U-1000P | C231329
NTC 10kΩ ±1% B3950 0603 | TH1 | R_0603_1608Metric | C2892547
USB PD3.2 sink controller ESSOP-10 | U2 | SSOP-10-1EP_3.9x4.9mm_P1mm_EP2.1x3.3mm | C42459160
eFuse 2.7-23V QFN-10 2x2 (RPW) | U3 | TI_RPW0010A_VQFN-HR-10_2x2mm | C3662799
3.8-30V 3A sync buck FCCM SOT-583 | U4 | SOT-583-8 | C5219272
2-ch ESD 5.5V 0.7pF SOT-323 | U5 | SOT-323_SC-70 | C5350871
Load switch 5.5V 2A SOT-23-6 | U6 | SOT-23-6 | C2681320
