momszx/esp32-p4-cam/kicad/MAIN/ESP32-P4-CAM-MAIN.kicad_pcb

## KiCad design kicad/MAIN/ESP32-P4-CAM-MAIN.kicad_pcb (2026-10-13)

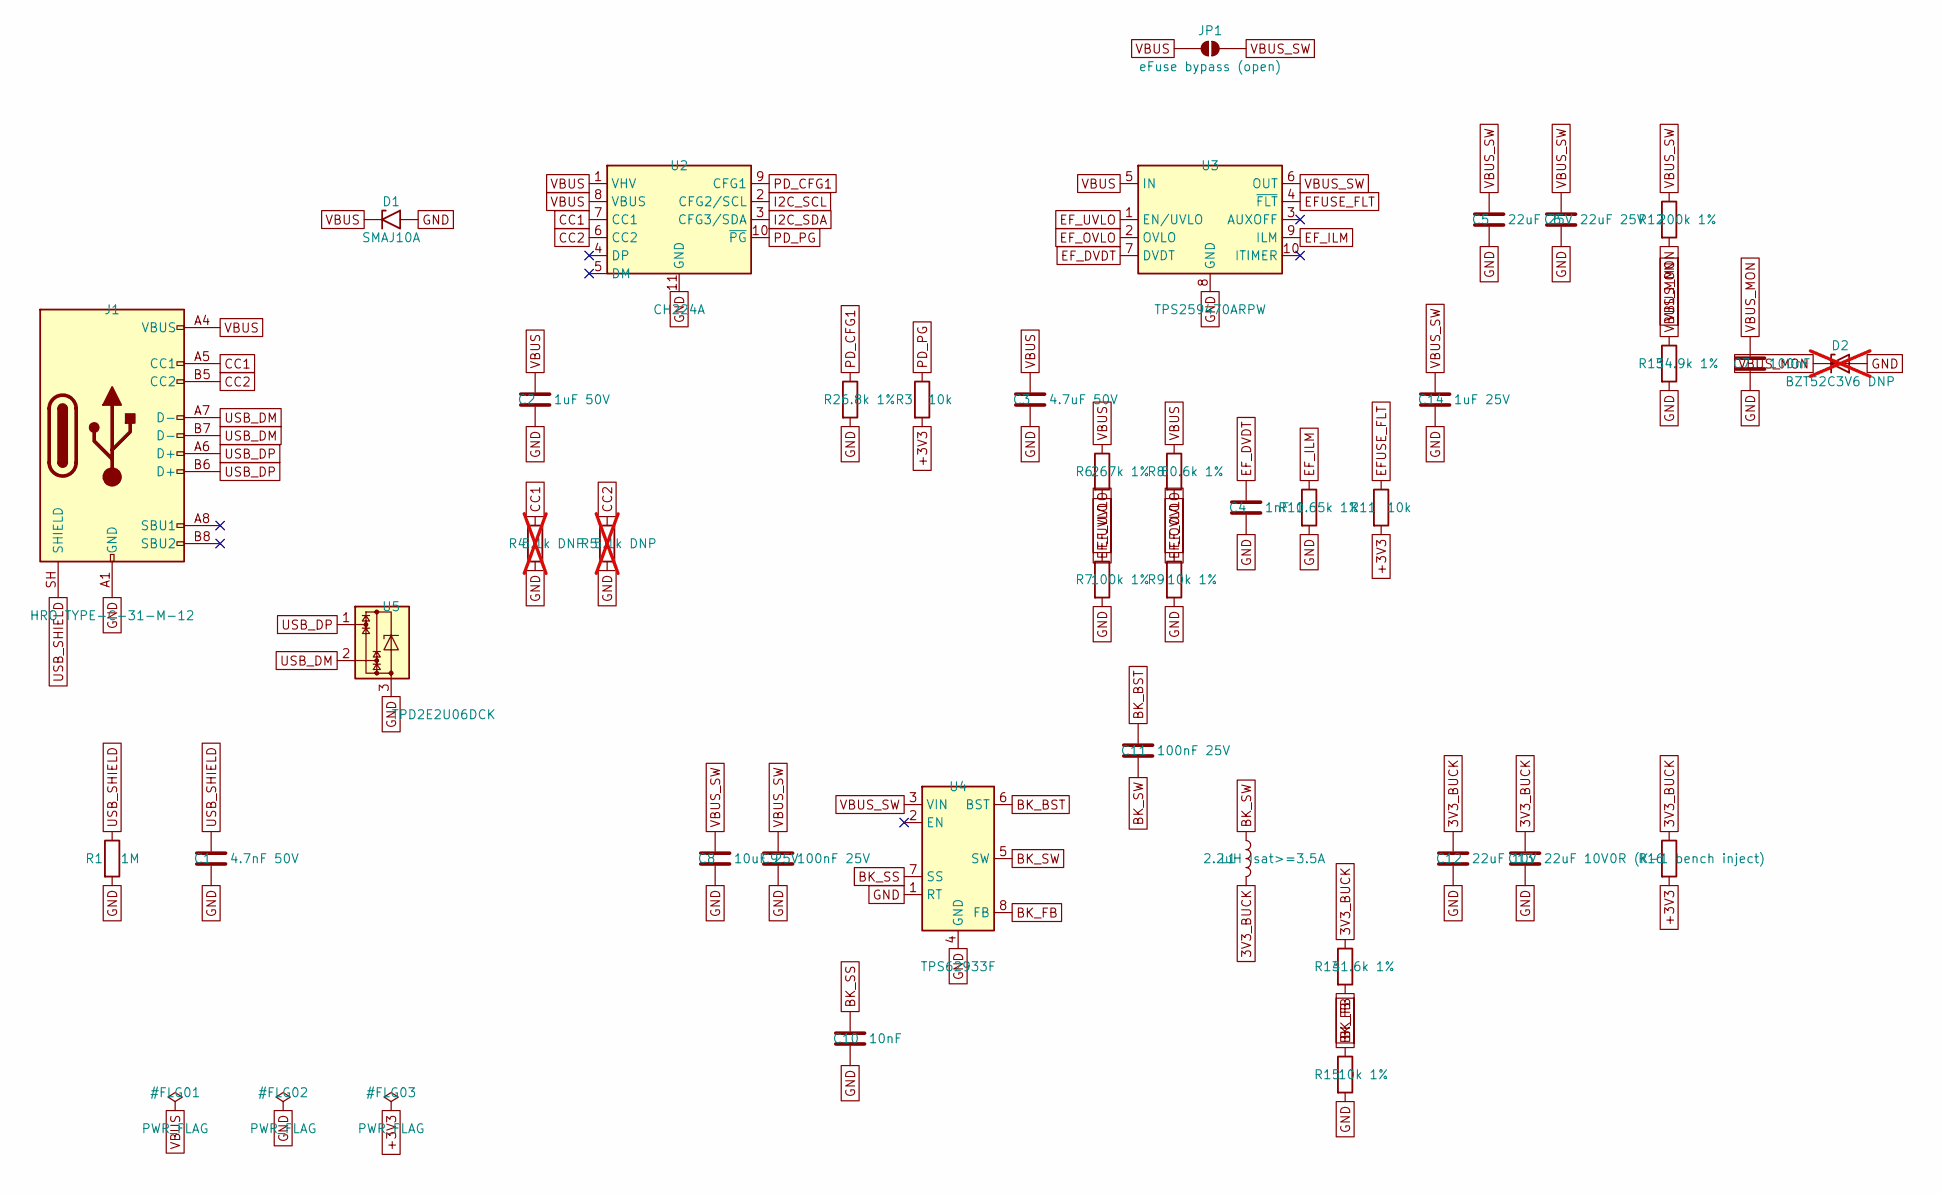
[picture p27: schematic 01_tap.kicad_sch]

Parts:
C1: 4.7nF 50V; C_0603_1608Metric; MPN CC0603KRX7RABB472; LCSC C596328
C2: 1uF 50V; C_0603_1608Metric; MPN CL10A105KB8NNNC; LCSC C15849
C3: 4.7uF 50V; C_0805_2012Metric; MPN CL21A475KBQNNNE; LCSC C98192
C4: 1nF; C_0603_1608Metric; MPN CL10B102KB8NNNC; LCSC C1588
C5, C6: 22uF 25V; C_1210_3225Metric; MPN CL32A226KAJNNNE; LCSC C52306
C7: 100nF; C_0603_1608Metric; MPN CC0603KRX7R9BB104; LCSC C14663
C8: 10uF 25V; C_0805_2012Metric; MPN CL21A106KAYNNNE; LCSC C15850
C9, C11: 100nF 25V; C_0603_1608Metric; MPN CC0603KRX7R9BB104; LCSC C14663
C10: 10nF; C_0603_1608Metric; MPN 0603B103K500NT; LCSC C57112
C12, C13: 22uF 10V; C_0805_2012Metric; MPN CL21A226MAQNNNE; LCSC C45783
C14: 1uF 25V; C_0603_1608Metric; MPN CL10B105KA8NNNC; LCSC C29936
D1: SMAJ10A; D_SMA; MPN SMAJ10A-13-F; LCSC C134939
D2: BZT52C3V6 DNP; D_SOD-123; not fitted
J1: HRO TYPE-C-31-M-12; USB_C_Receptacle_HRO_TYPE-C-31-M-12; MPN TYPE-C-31-M-12; LCSC C165948
JP1: eFuse bypass (open); SolderJumper-2_P1.3mm_Open_RoundedPad1.0x1.5mm
L1: 2.2uH Isat>=3.5A; L_Taiyo-Yuden_NR-50xx; MPN NRS5024T2R2NMGJ; LCSC C222926
R1: 1M; R_0603_1608Metric; MPN 0603WAF1004T5E; LCSC C22935
R2: 6.8k 1%; R_0603_1608Metric; MPN 0603WAF6801T5E; LCSC C23212
R3, R11: 10k; R_0603_1608Metric; MPN 0603WAF1002T5E; LCSC C25804
R4, R5: 5.1k DNP; R_0603_1608Metric; not fitted
R6: 267k 1%; R_0603_1608Metric; MPN 0603WAF2673T5E; LCSC C22963
R7: 100k 1%; R_0603_1608Metric; MPN 0603WAF1003T5E; LCSC C25803
R8: 80.6k 1%; R_0603_1608Metric; MPN 0603WAF8062T5E; LCSC C23249
R9, R15: 10k 1%; R_0603_1608Metric; MPN 0603WAF1002T5E; LCSC C25804
R10: 1.65k 1%; R_0603_1608Metric; MPN 0603WAF1651T5E; LCSC C22845
R12: 200k 1%; R_0603_1608Metric; MPN 0603WAF2003T5E; LCSC C25811
R13: 54.9k 1%; R_0603_1608Metric; MPN 0603WAF5492T5E; LCSC C23077
R14: 31.6k 1%; R_0603_1608Metric; MPN 0603WAF3162T5E; LCSC C25967
R16: 0R (K-1 bench inject); R_0805_2012Metric; MPN 0805W8F0000T5E; LCSC C17477
U2: CH224A; SSOP-10-1EP_3.9x4.9mm_P1mm_EP2.1x3.3mm; MPN CH224A; LCSC C42459160
U3: TPS259470ARPW; TI_RPW0010A_VQFN-HR-10_2x2mm; MPN TPS259470ARPWR; LCSC C3662799
U4: TPS62933F; SOT-583-8; MPN TPS62933FDRLR; LCSC C5219272
U5: TPD2E2U06DCK; SOT-323_SC-70; MPN TPD2E2U06DCKR-TP; LCSC C5350871

Connections:
3V3_BUCK: C12.1, C13.1, L1.2, R14.1, R16.1
+3V3: R3.2, R11.2, R16.2; also elsewhere on the board
BK_BST: C11.1, U4.6 (BST)
BK_FB: R14.2, R15.1, U4.8 (FB)
BK_SS: C10.1, U4.7 (SS)
BK_SW: C11.2, L1.1, U4.5 (SW)
CC1: J1.A5 (CC1), R4.1, U2.7 (CC1)
CC2: J1.B5 (CC2), R5.1, U2.6 (CC2)
EFUSE_FLT: R11.1, U3.4 (~FLT); also elsewhere on the board
EF_DVDT: C4.1, U3.7 (DVDT)
EF_ILM: R10.1, U3.9 (ILM)
EF_OVLO: R8.2, R9.1, U3.2 (OVLO)
EF_UVLO: R6.2, R7.1, U3.1 (EN/UVLO)
GND: C1.2, C2.2, C3.2, C4.2, C5.2, C6.2, C7.2, C8.2, C9.2, C10.2, C12.2, C13.2, C14.2, D1.2 (A2), D2.2 (A), J1.A1 (GND), J1.A12 (GND), J1.B1 (GND), J1.B12 (GND), R1.2, R2.2, R4.2, R5.2, R7.2, R9.2, R10.2, R13.2, R15.2, U2.11 (GND), U3.8 (GND), U4.1 (RT), U4.4 (GND), U5.3; also elsewhere on the board
I2C_SCL: U2.2 (CFG2/SCL); also elsewhere on the board
I2C_SDA: U2.3 (CFG3/SDA); also elsewhere on the board
PD_CFG1: R2.1, U2.9 (CFG1)
PD_PG: R3.1, U2.10 (~PG); also elsewhere on the board
USB_DM: J1.A7 (D-), J1.B7 (D-), U5.2; also elsewhere on the board
USB_DP: J1.A6 (D+), J1.B6 (D+), U5.1; also elsewhere on the board
USB_SHIELD: C1.1, J1.SH (SHIELD), R1.1
VBUS: C2.1, C3.1, D1.1 (A1), J1.A4 (VBUS), J1.A9 (VBUS), J1.B4 (VBUS), J1.B9 (VBUS), JP1.1 (A), R6.1, R8.1, U2.1 (VHV), U2.8 (VBUS), U3.5 (IN); also elsewhere on the board
VBUS_MON: C7.1, D2.1 (K), R12.2, R13.1; also elsewhere on the board
VBUS_SW: C5.1, C6.1, C8.1, C9.1, C14.1, JP1.2 (B), R12.1, U3.6 (OUT), U4.3 (VIN); also elsewhere on the board

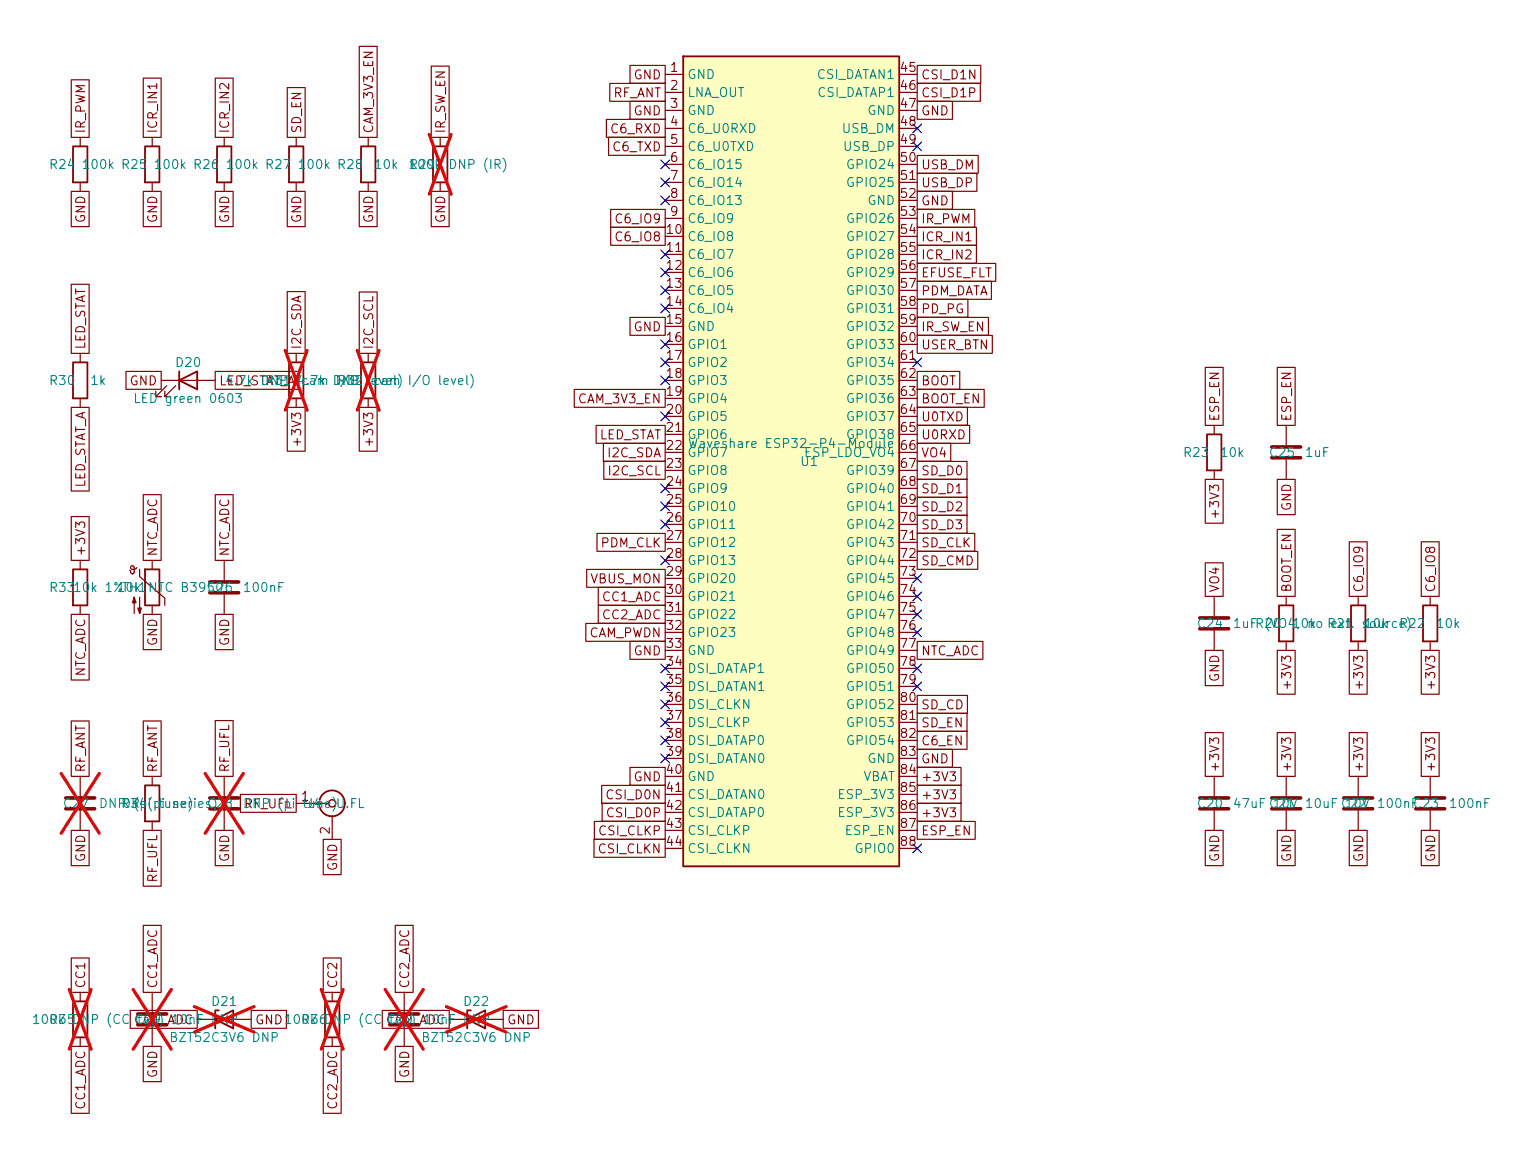
[picture p28: schematic 02_p4_modul.kicad_sch]

Parts:
C20: 47uF 10V; C_1210_3225Metric; MPN GRM32ER61C476KE15L; LCSC C77101
C21: 10uF 10V; C_0805_2012Metric; MPN CL21A106KAYNNNE; LCSC C15850
C22, C23, C26: 100nF; C_0603_1608Metric; MPN CC0603KRX7R9BB104; LCSC C14663
C24: 1uF (VO4, no ext. source); C_0603_1608Metric; MPN CL10A105KB8NNNC; LCSC C15849
C25: 1uF; C_0603_1608Metric; MPN CL10A105KB8NNNC; LCSC C15849
C27, C28: DNP (pi tune); C_0402_1005Metric; not fitted
C29, C30: 10nF DNP; C_0603_1608Metric; not fitted
D20: LED green 0603; LED_0603_1608Metric; MPN KT-0603G; LCSC C12624
D21, D22: BZT52C3V6 DNP; D_SOD-123; not fitted
J4: U.FL; U.FL_Hirose_U.FL-R-SMT-1_Vertical; MPN U.FL-R-SMT-1(80); LCSC C88374
R20, R21, R22, R23, R28: 10k; R_0603_1608Metric; MPN 0603WAF1002T5E; LCSC C25804
R24, R25, R26, R27: 100k; R_0603_1608Metric; MPN 0603WAF1003T5E; LCSC C25803
R29: 100k DNP (IR); R_0603_1608Metric; not fitted
R30: 1k; R_0603_1608Metric; MPN 0603WAF1001T5E; LCSC C21190
R31, R32: 4.7k DNP (cam I/O level); R_0603_1608Metric; not fitted
R33: 10k 1%; R_0603_1608Metric; MPN 0603WAF1002T5E; LCSC C25804
R34: 0R (pi series); R_0402_1005Metric; MPN 0402WGF0000TCE; LCSC C17168
R35, R36: 100k DNP (CC tap); R_0603_1608Metric; not fitted
TH1: 10k NTC B3950; R_0603_1608Metric; MPN KNTC0603/10KF3950; LCSC C2892547
U1: Waveshare ESP32-P4-Module; Waveshare_ESP32-P4-Module_HandSolder

Connections:
+3V3: C20.1, C21.1, C22.1, C23.1, R20.2, R21.2, R22.2, R23.2, R31.2, R32.2, R33.1, U1.84 (VBAT), U1.85 (ESP_3V3), U1.86 (ESP_3V3); also elsewhere on the board
BOOT: U1.62 (GPIO35); also elsewhere on the board
BOOT_EN: R20.1, U1.63 (GPIO36)
C6_EN: U1.82 (GPIO54); also elsewhere on the board
C6_IO8: R22.1, U1.10 (C6_IO8); also elsewhere on the board
C6_IO9: R21.1, U1.9 (C6_IO9); also elsewhere on the board
C6_RXD: U1.4 (C6_U0RXD); also elsewhere on the board
C6_TXD: U1.5 (C6_U0TXD); also elsewhere on the board
CAM_3V3_EN: R28.1, U1.19 (GPIO4); also elsewhere on the board
CAM_PWDN: U1.32 (GPIO23); also elsewhere on the board
CC1_ADC: C29.1, D21.1 (K), R35.2, U1.30 (GPIO21)
CC2_ADC: C30.1, D22.1 (K), R36.2, U1.31 (GPIO22)
CSI_CLKN: U1.44 (CSI_CLKN); also elsewhere on the board
CSI_CLKP: U1.43 (CSI_CLKP); also elsewhere on the board
CSI_D0N: U1.41 (CSI_DATAN0); also elsewhere on the board
CSI_D0P: U1.42 (CSI_DATAP0); also elsewhere on the board
CSI_D1N: U1.45 (CSI_DATAN1); also elsewhere on the board
CSI_D1P: U1.46 (CSI_DATAP1); also elsewhere on the board
EFUSE_FLT: U1.56 (GPIO29); also elsewhere on the board
ESP_EN: C25.1, R23.1, U1.87 (ESP_EN); also elsewhere on the board
GND: C20.2, C21.2, C22.2, C23.2, C24.2, C25.2, C26.2, C27.2, C28.2, C29.2, C30.2, D20.1 (K), D21.2 (A), D22.2 (A), J4.2 (Ext), R24.2, R25.2, R26.2, R27.2, R28.2, R29.2, TH1.2, U1.1 (GND), U1.3 (GND), U1.15 (GND), U1.33 (GND), U1.40 (GND), U1.47 (GND), U1.52 (GND), U1.83 (GND); also elsewhere on the board
I2C_SCL: R32.1, U1.23 (GPIO8); also elsewhere on the board
I2C_SDA: R31.1, U1.22 (GPIO7); also elsewhere on the board
ICR_IN1: R25.1, U1.54 (GPIO27); also elsewhere on the board
ICR_IN2: R26.1, U1.55 (GPIO28); also elsewhere on the board
IR_PWM: R24.1, U1.53 (GPIO26); also elsewhere on the board
IR_SW_EN: R29.1, U1.59 (GPIO32); also elsewhere on the board
LED_STAT: R30.1, U1.21 (GPIO6)
LED_STAT_A: D20.2 (A), R30.2
NTC_ADC: C26.1, R33.2, TH1.1, U1.77 (GPIO49)
PDM_CLK: U1.27 (GPIO12); also elsewhere on the board
PDM_DATA: U1.57 (GPIO30); also elsewhere on the board
PD_PG: U1.58 (GPIO31); also elsewhere on the board
RF_ANT: C27.1, R34.1, U1.2 (LNA_OUT)
RF_UFL: C28.1, J4.1 (In), R34.2
SD_CD: U1.80 (GPIO52); also elsewhere on the board
SD_CLK: U1.71 (GPIO43); also elsewhere on the board
SD_CMD: U1.72 (GPIO44); also elsewhere on the board
SD_D0: U1.67 (GPIO39); also elsewhere on the board
SD_D1: U1.68 (GPIO40); also elsewhere on the board
SD_D2: U1.69 (GPIO41); also elsewhere on the board
SD_D3: U1.70 (GPIO42); also elsewhere on the board
SD_EN: R27.1, U1.81 (GPIO53); also elsewhere on the board
U0RXD: U1.65 (GPIO38); also elsewhere on the board
U0TXD: U1.64 (GPIO37); also elsewhere on the board
USB_DM: U1.50 (GPIO24); also elsewhere on the board
USB_DP: U1.51 (GPIO25); also elsewhere on the board
USER_BTN: U1.60 (GPIO33); also elsewhere on the board
VBUS_MON: U1.29 (GPIO20); also elsewhere on the board
VO4: C24.1, U1.66 (ESP_LDO_VO4); also elsewhere on the board

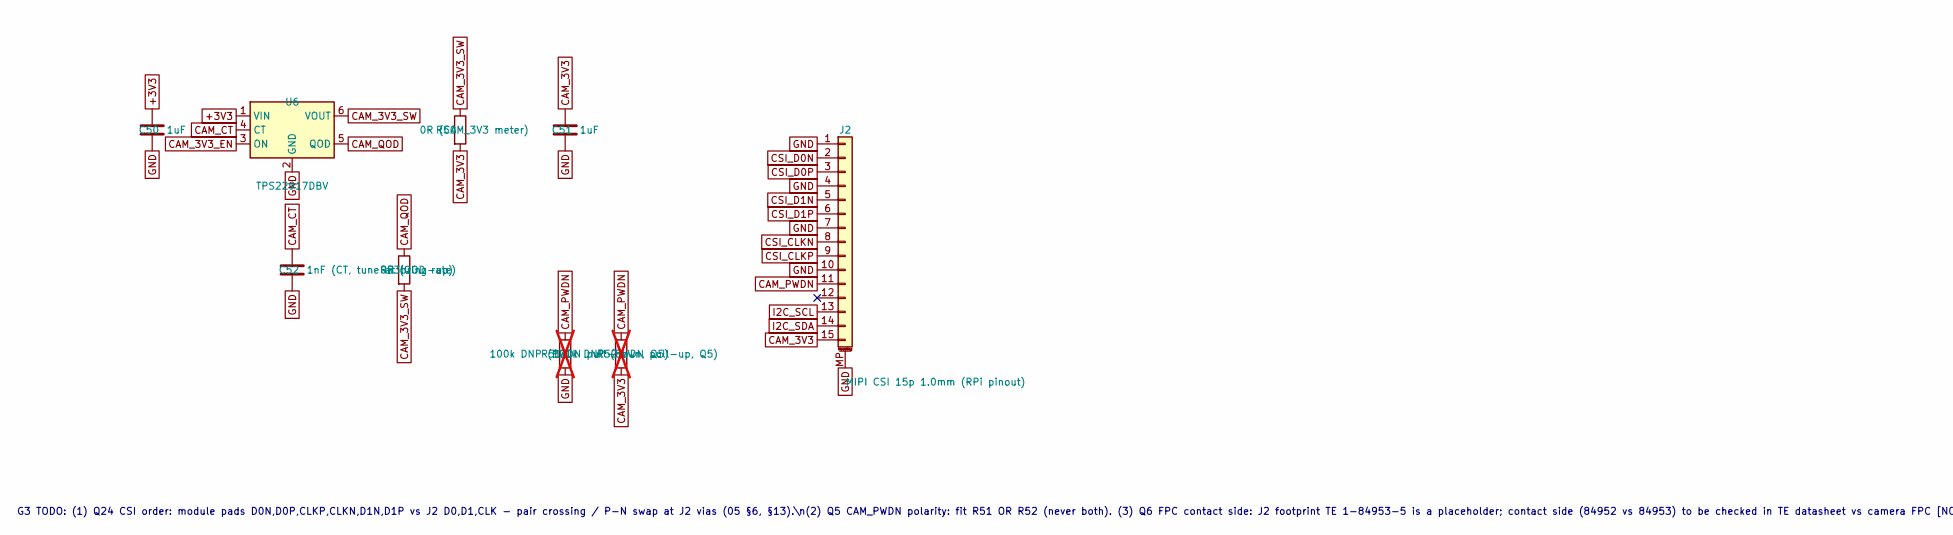
[picture p29: schematic 03_kamera.kicad_sch, part in row 1, column 1]

Parts:
C50, C51: 1uF; C_0603_1608Metric; MPN CL10A105KB8NNNC; LCSC C15849
C52: 1nF (CT, tune at bring-up); C_0603_1608Metric; MPN CL10B102KB8NNNC; LCSC C1588
J2: MIPI CSI 15p 1.0mm (RPi pinout); TE_1-84953-5_1x15-1MP_P1.0mm_Horizontal; MPN 1-84953-5; LCSC C5164008
R50: 0R (CAM_3V3 meter); R_0603_1608Metric; MPN 0603WAF0000T5E; LCSC C21189
R51: 100k DNP (PWDN pull-down, Q5); R_0603_1608Metric; not fitted
R52: 100k DNP (PWDN pull-up, Q5); R_0603_1608Metric; not fitted
R53: 0R (QOD rate); R_0603_1608Metric; MPN 0603WAF0000T5E; LCSC C21189
U6: TPS22917DBV; SOT-23-6; MPN TPS22917DBVR; LCSC C2681320

Connections:
+3V3: C50.1, U6.1 (VIN); also elsewhere on the board
CAM_3V3: C51.1, J2.15, R50.2, R52.2; also elsewhere on the board
CAM_3V3_EN: U6.3 (ON); also elsewhere on the board
CAM_3V3_SW: R50.1, R53.2, U6.6 (VOUT)
CAM_CT: C52.1, U6.4 (CT)
CAM_PWDN: J2.11, R51.1, R52.1; also elsewhere on the board
CAM_QOD: R53.1, U6.5 (QOD)
CSI_CLKN: J2.8; also elsewhere on the board
CSI_CLKP: J2.9; also elsewhere on the board
CSI_D0N: J2.2; also elsewhere on the board
CSI_D0P: J2.3; also elsewhere on the board
CSI_D1N: J2.5; also elsewhere on the board
CSI_D1P: J2.6; also elsewhere on the board
GND: C50.2, C51.2, C52.2, J2.1, J2.4, J2.7, J2.10, J2.MP (MountPin), R51.2, U6.2 (GND); also elsewhere on the board
I2C_SCL: J2.13; also elsewhere on the board
I2C_SDA: J2.14; also elsewhere on the board

Notes on the sheet:
G3 TODO: (1) Q24 CSI order: module pads D0N,D0P,CLKP,CLKN,D1N,D1P vs J2 D0,D1,CLK - pair crossing / P-N swap at J2 vias (05 §6, §13).\n(2) Q5 CAM_PWDN polarity: fit R51 OR R52 (never both). (3) Q6 FPC contact side: J2 footprint TE 1-84953-5 is a placeholder; contact side (84952 vs 84953) to be chec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

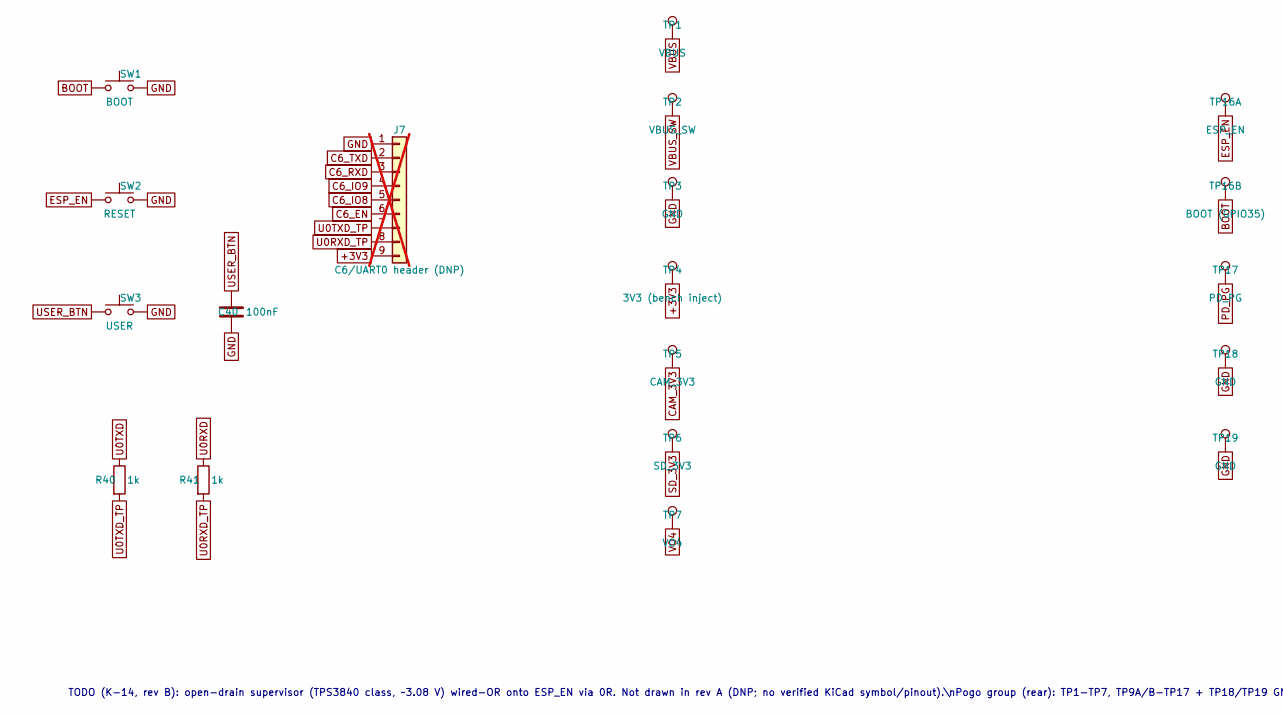
[picture p30: schematic 04_prog_tp.kicad_sch, part in row 1, column 1]

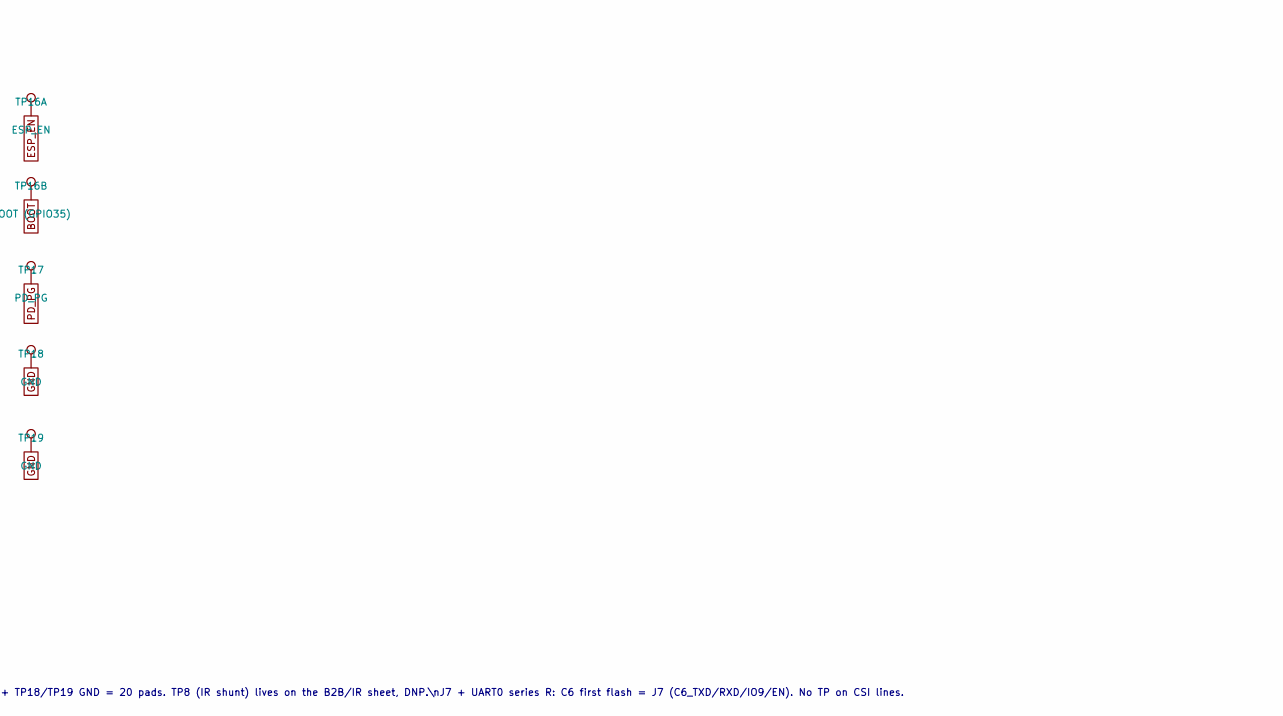
[picture p31: schematic 04_prog_tp.kicad_sch, part in row 1, column 2]

Parts:
C40: 100nF; C_0603_1608Metric; MPN CC0603KRX7R9BB104; LCSC C14663
J7: C6/UART0 header (DNP); PadRow_1x09_P1.27mm_SMD; not fitted
R40, R41: 1k; R_0603_1608Metric; MPN 0603WAF1001T5E; LCSC C21190
SW1: BOOT; SW_SPST_B3U-1000P; MPN B3U-1000P; LCSC C231329
SW2: RESET; SW_SPST_B3U-1000P; MPN B3U-1000P; LCSC C231329
SW3: USER; SW_SPST_B3U-1000P; MPN B3U-1000P; LCSC C231329
TP1: VBUS; TestPoint_Pad_D1.5mm
TP2: VBUS_SW; TestPoint_Pad_D1.5mm
TP3, TP18, TP19: GND; TestPoint_Pad_D1.5mm
TP4: 3V3 (bench inject); TestPoint_Pad_D1.5mm
TP5: CAM_3V3; TestPoint_Pad_D1.5mm
TP6: SD_3V3; TestPoint_Pad_D1.5mm
TP7: VO4; TestPoint_Pad_D1.5mm
TP16A: ESP_EN; TestPoint_Pad_D1.5mm
TP16B: BOOT (GPIO35); TestPoint_Pad_D1.5mm
TP17: PD_PG; TestPoint_Pad_D1.5mm

Connections:
+3V3: J7.9, TP4.1; also elsewhere on the board
BOOT: SW1.1, TP16B.1; also elsewhere on the board
C6_EN: J7.6; also elsewhere on the board
C6_IO8: J7.5; also elsewhere on the board
C6_IO9: J7.4; also elsewhere on the board
C6_RXD: J7.3; also elsewhere on the board
C6_TXD: J7.2; also elsewhere on the board
CAM_3V3: TP5.1; also elsewhere on the board
ESP_EN: SW2.1, TP16A.1; also elsewhere on the board
GND: C40.2, J7.1, SW1.2, SW2.2, SW3.2, TP3.1, TP18.1, TP19.1; also elsewhere on the board
PD_PG: TP17.1; also elsewhere on the board
SD_3V3: TP6.1; also elsewhere on the board
U0RXD: R41.1; also elsewhere on the board
U0RXD_TP: J7.8, R41.2
U0TXD: R40.1; also elsewhere on the board
U0TXD_TP: J7.7, R40.2
USER_BTN: C40.1, SW3.1; also elsewhere on the board
VBUS: TP1.1; also elsewhere on the board
VBUS_SW: TP2.1; also elsewhere on the board
VO4: TP7.1; also elsewhere on the board

Notes on the sheet:
TODO (K-14, rev B): open-drain supervisor (TPS3840 class, ~3.08 V) wired-OR onto ESP_EN via 0R. Not drawn in rev A (DNP; no verified KiCad symbol/pinout).\nPogo group (rear): TP1-TP7, TP9A/B-TP17 + TP18/TP19 GND = 20 pads. TP8 (IR shunt) lives on the B2B/IR sheet, DNP.\nJ7 + UART0 series R: C6 firs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

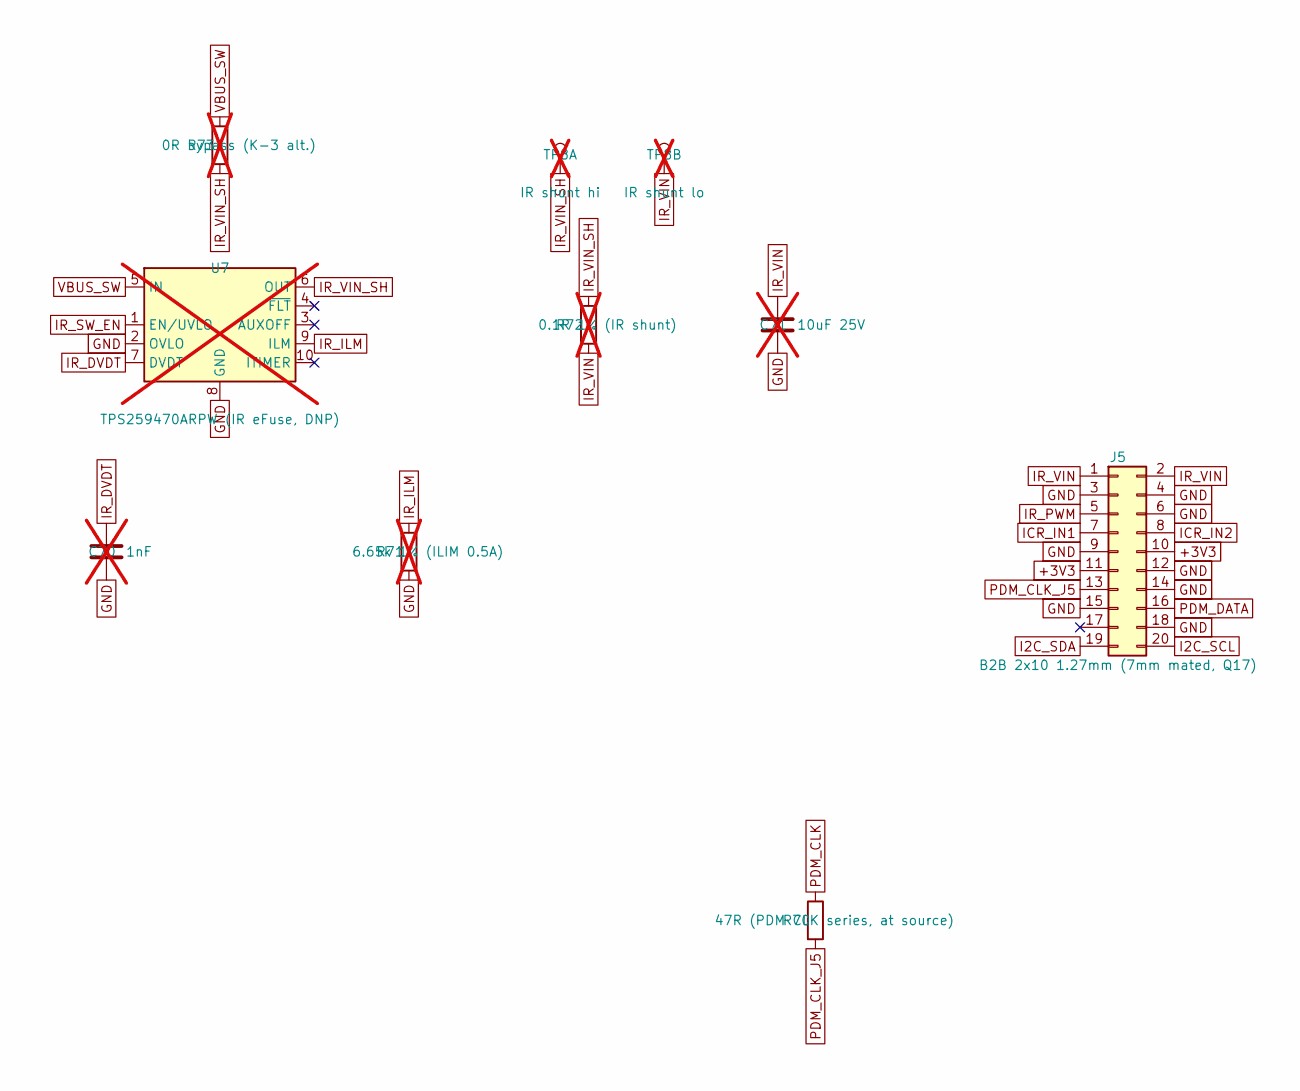
[picture p32: schematic 05_b2b_front.kicad_sch]

Parts:
C70: 1nF; C_0603_1608Metric; not fitted
C71: 10uF 25V; C_0805_2012Metric; not fitted
J5: B2B 2x10 1.27mm (7mm mated, Q17); PinHeader_2x10_P1.27mm_Vertical_SMD; MPN HC-PZ127-7.2L-2x10PS; LCSC C41375929
R70: 47R (PDM CLK series, at source); R_0603_1608Metric; MPN 0603WAF470JT5E; LCSC C23182
R71: 6.65k 1% (ILIM 0.5A); R_0603_1608Metric; not fitted
R72: 0.1R 1% (IR shunt); R_0805_2012Metric; not fitted
R73: 0R bypass (K-3 alt.); R_0805_2012Metric; not fitted
TP8A: IR shunt hi; TestPoint_Pad_D1.5mm; not fitted
TP8B: IR shunt lo; TestPoint_Pad_D1.5mm; not fitted
U7: TPS259470ARPW (IR eFuse, DNP); TI_RPW0010A_VQFN-HR-10_2x2mm; not fitted

Connections:
+3V3: J5.10, J5.11; also elsewhere on the board
GND: C70.2, C71.2, J5.3, J5.4, J5.6, J5.9, J5.12, J5.14, J5.15, J5.18, R71.2, U7.2 (OVLO), U7.8 (GND); also elsewhere on the board
I2C_SCL: J5.20; also elsewhere on the board
I2C_SDA: J5.19; also elsewhere on the board
ICR_IN1: J5.7; also elsewhere on the board
ICR_IN2: J5.8; also elsewhere on the board
IR_DVDT: C70.1, U7.7 (DVDT)
IR_ILM: R71.1, U7.9 (ILM)
IR_PWM: J5.5; also elsewhere on the board
IR_SW_EN: U7.1 (EN/UVLO); also elsewhere on the board
IR_VIN: C71.1, J5.1, J5.2, R72.2, TP8B.1
IR_VIN_SH: R72.1, R73.2, TP8A.1, U7.6 (OUT)
PDM_CLK: R70.1; also elsewhere on the board
PDM_CLK_J5: J5.13, R70.2
PDM_DATA: J5.16; also elsewhere on the board
VBUS_SW: R73.1, U7.5 (IN); also elsewhere on the board

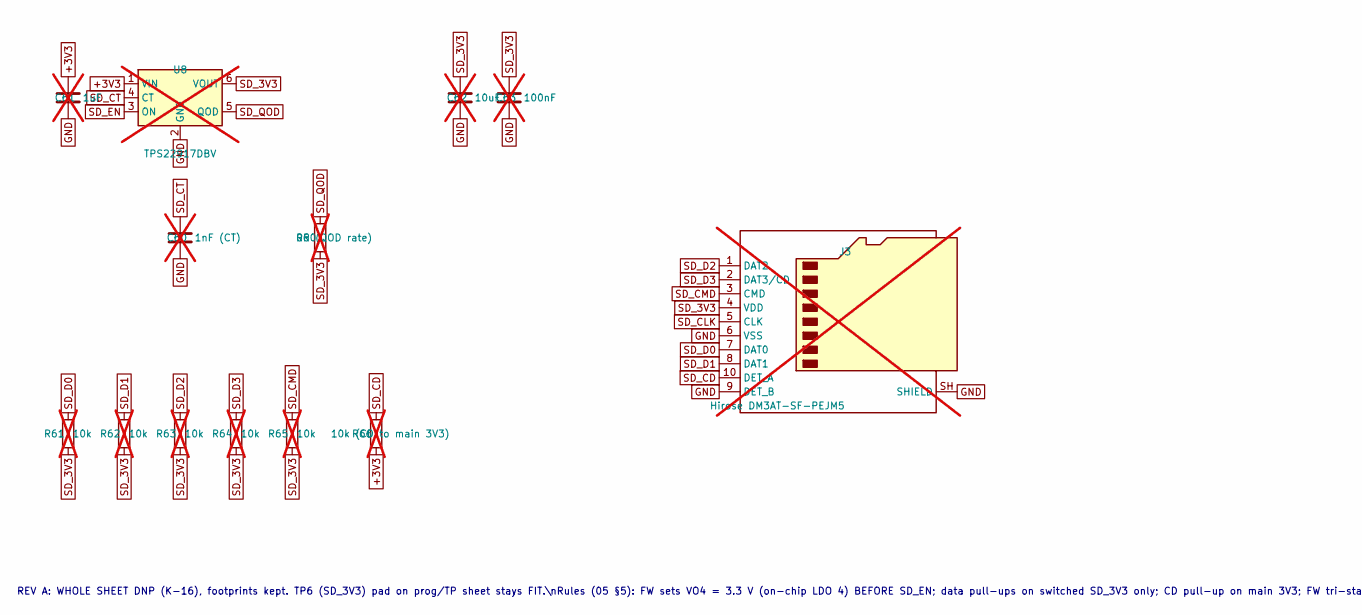
[picture p33: schematic 06_sd.kicad_sch, part in row 1, column 1]

Parts:
C60: 1nF (CT); C_0603_1608Metric; not fitted
C61: 1uF; C_0603_1608Metric; not fitted
C62: 10uF; C_0805_2012Metric; not fitted
C63: 100nF; C_0603_1608Metric; not fitted
J3: Hirose DM3AT-SF-PEJM5; microSD_HC_Hirose_DM3AT-SF-PEJM5; not fitted
R60: 0R (QOD rate); R_0603_1608Metric; not fitted
R61, R62, R63, R64, R65: 10k; R_0603_1608Metric; not fitted
R66: 10k (CD to main 3V3); R_0603_1608Metric; not fitted
U8: TPS22917DBV; SOT-23-6; not fitted

Connections:
+3V3: C61.1, R66.2, U8.1 (VIN); also elsewhere on the board
GND: C60.2, C61.2, C62.2, C63.2, J3.6 (VSS), J3.9 (DET_B), J3.SH (SHIELD), U8.2 (GND); also elsewhere on the board
SD_3V3: C62.1, C63.1, J3.4 (VDD), R60.2, R61.2, R62.2, R63.2, R64.2, R65.2, U8.6 (VOUT); also elsewhere on the board
SD_CD: J3.10 (DET_A), R66.1; also elsewhere on the board
SD_CLK: J3.5 (CLK); also elsewhere on the board
SD_CMD: J3.3 (CMD), R65.1; also elsewhere on the board
SD_CT: C60.1, U8.4 (CT)
SD_D0: J3.7 (DAT0), R61.1; also elsewhere on the board
SD_D1: J3.8 (DAT1), R62.1; also elsewhere on the board
SD_D2: J3.1 (DAT2), R63.1; also elsewhere on the board
SD_D3: J3.2 (DAT3/CD), R64.1; also elsewhere on the board
SD_EN: U8.3 (ON); also elsewhere on the board
SD_QOD: R60.1, U8.5 (QOD)

Notes on the sheet:
REV A: WHOLE SHEET DNP (K-16), footprints kept. TP6 (SD_3V3) pad on prog/TP sheet stays FIT.\nRules (05 §5): FW sets VO4 = 3.3 V (on-chip LDO 4) BEFORE SD_EN; data pull-ups on switched SD_3V3 only; CD pull-up on main 3V3; FW tri-states SD pins before SD_EN off.\nsdkconfig: override IDF default SD p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

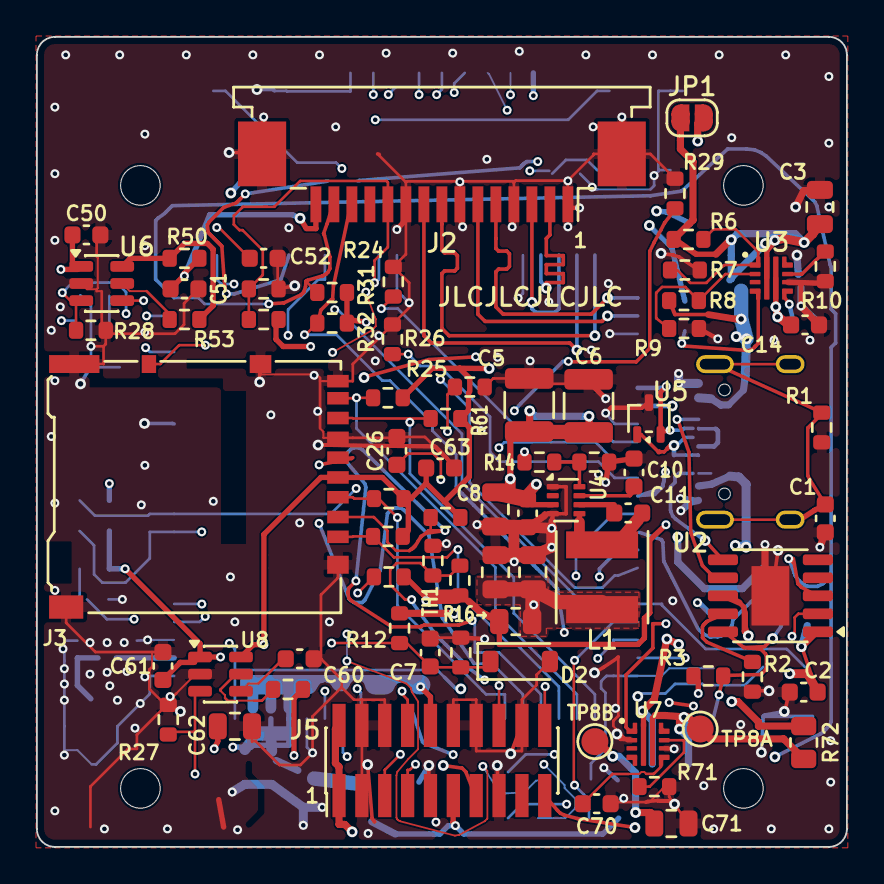
[picture p34: board ESP32-P4-CAM-MAIN.kicad_pcb from above]

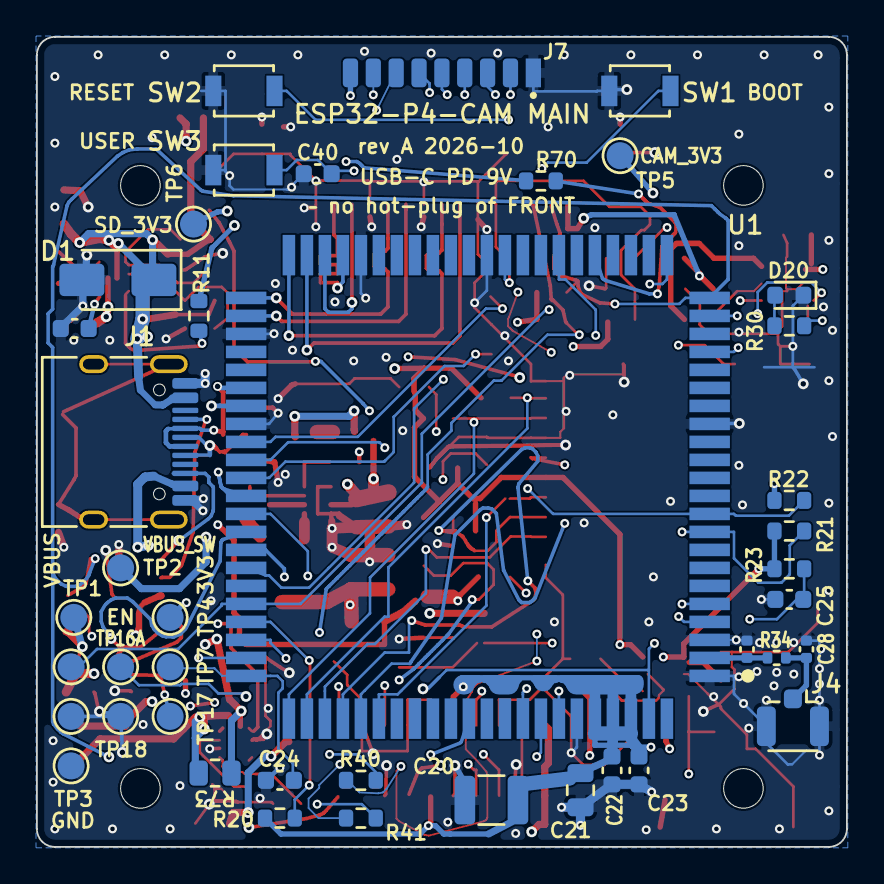
[picture p35: board ESP32-P4-CAM-MAIN.kicad_pcb from below]

Board: 4 copper layers, 45.0 x 45.0 mm, 120 parts (42 on the bottom side), 77 nets.

Other parts of the board:
MH1, MH2, MH3, MH4: MountingHole_2.2mm_M2
