momszx/esp32-p4-cam/(commit log)

2026-10-12 docs: import ESP32-P4-CAM MAIN rev A design with English documentation
    - KiCad 10 MAIN board (4-layer 45x45 mm, JLC04101H-3313A): schematic (6 sheets),
    PCB, custom library, archived 2-layer attempt
    - Rev A status: DRC 0 errors, ERC 0, schematic/board parity 0, 12 DNP-only
    unconnected; conditional GO for ordering (see kicad/MAIN/fab/ORDERING.md)
    - JLC fab package: Gerbers + drill, BOM (LCSC numbers), 72-row CPL
    - English docs (00-09, 90 review log) translated from the Hungarian originals,
    which are kept frozen in docs/hu/; new 09-pcb-layers.md with per-layer plots
    - Layout automation scripts (pcbmerge/regioncheck parallel-edit tools, maze
    router, netmap renderer) with a README
    - Third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
    [01_tap.kicad_sch, 02_p4_modul.kicad_sch, 03_kamera.kicad_sch, 04_prog_tp.kicad_sch, 05_b2b_front.kicad_sch, 06_sd.kicad_sch, BOM_jlc.csv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]
2026-10-13 fix: route IR eFuse branch and drop CC option footprints for zero unconnected
    An external review flagged the 12 DNP-only ratsnest items left after round 8.
    - IR eFuse U7/R73 (still DNP) is now routed: U7.5 VBUS_SW feed from the
    In2 plane (2x 0.6/0.3 vias), U7.8 GND via, R73 moved to B under U7.
    The branch can be fitted later without bodge wires.
    - CC option group R4/R5/R35/R36/C29/C30/D21/D22: a routing attempt was
    rejected by the checker (VBUS_SW plane split, GND pour fragmentation,
    ADC stubs next to CSI, 11-13 mm CC2 stubs). The symbols stay in the
    schematic as a rev B option but are excluded from the board; their
    footprints and 5 leftover CC2 stub tracks are removed.
    - Pre-or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
    [01_tap.kicad_sch, 02_p4_modul.kicad_sch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]
